aviatorblue62/sFPI/App/README.txt

Notes: 

Need to make windows image smaller to account for the small screen size.

Possibly measure the screen size with python and resize the image based on the screen size (i.e. crop it). 
This will be fine since the scaling will be determined by the ImageProcessing function.
