aviatorblue62/sFPI/Optical_Design/sfpi_layout.pdf

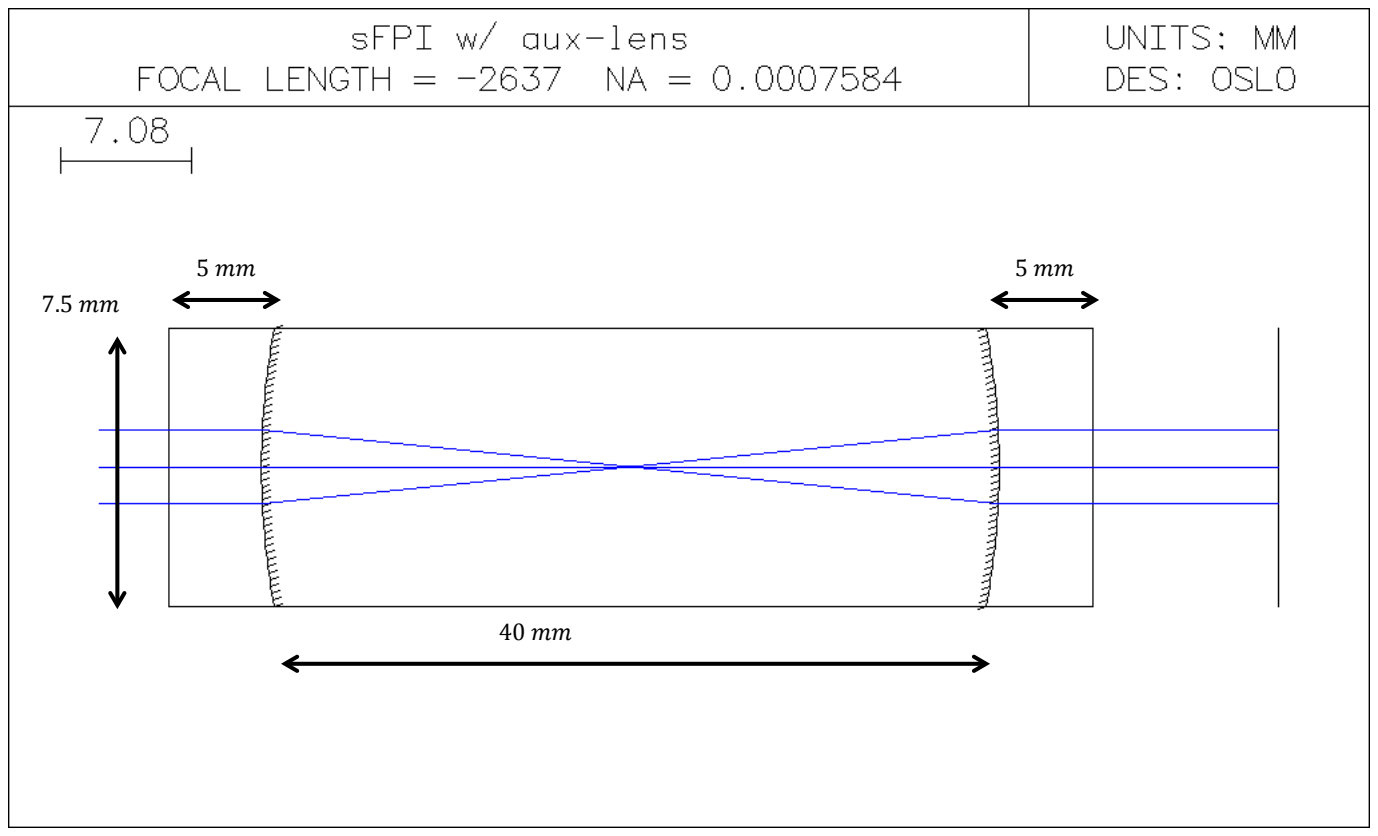
[picture p58: page 1]

7.5 mm

40 mm

5 mm | 5 mm
