aviatorblue62/sFPI/Docs/Thesis/OIT_Thesis.pdf

# The Design, Development and Implementation of a Scanning Fabry-Perot Interferometer

### David M Houston Oregon Institute of Technology

### April 7, 2015

# Contents

1 Background | 1
2 Motivation | 4
3 Proposed Plan | 5
4 Evaluation | 11
5 Timeline | 12
Appendices | 13
A Schematics | 14

# List of Figures

1.1 Resonant Cavity Setup | | 1
1.2 Auxiliary Lens Setup | | 2
1.3 Spectra Physics Model 476 High-Voltage Output | | 3
3.1 Block Diagram | | 5
3.2 Resonant Cavity Design | | 6
3.3 Resonant Cavity Mechanical Design | | 7
3.4 Ramp Function | | 8
3.5 RC Diode Circuit | | 8
3.6 Driver Amplifier | | 9
3.7 RLC Filter | | 9
3.8 Photodiode Output Circuit | | 10
5.1 Timeline | | 12
A.1 SP-476 Schematic | | 15
A.2 Amplifier Schematic | | 16

# List of Tables

3.1 Design Specification for Resonant Cavity | | 7
3.2 Design Specifications for Driver Amplifier of 5V sawtooth wave at 50 and 100 Hz . | 9
3.3 Specifications for sFPI Driver Output Signal | | 9
3.4 Design Specifications for Photodiode Transimpedance Amplifier | | 10

Project Goal

The goal of the project is to design, build, and implement a scanning mirror Fabry-Perot Interferometer. This device characterizes the spectral content of a laser beam. It will have a finesse of 155 and frequency spectral range of 3.748 GHz with a resolution of 24 MHz. A piezoelectric device will change the spacing of the mirrors, allowing scanning across the entire free spectral range. A driver will provide a controllable voltage signal to the piezoelectric device. The spectral frequency content will be captured by a photodetector and amplified by an adjustable transimpedance amplifier with a gain range of 50dB. A computer will process, display, and store this data locally on its hard disk.

# Section 1

# The Fabry-Perot Interferometer

The scanning Fabry-Perot Interferometer (sFPI) allows high-resolution optical spectroscopy. An example of this device is the Spectra Physics 470-04 Interferometer (SP-470-04), which is ”a mode degenerate, spherical mirror, Fabry-Perot interferometer”. It has a confocal resonant cavity with a minimum finesse of 150 and a free spectral range (FSR) of 8 GHz. This is calculated by Eq. 1.1 [6].

F

∗ = π

√
R
1 − R

(1.1)

The sFPI “can be used as a scanning spectrum analyzer..., as a static fringe interferometer, or as a tunable optical filter...” [6]. The SP-470-04 is comprised of a resonant cavity, capable of scanning, a driver, and a photo-detection setup for data analysis. The resonant cavity is constructed of a confocal mirror setup with an auxiliary lens as seen in Figures 1.1 and 1.2 [3].

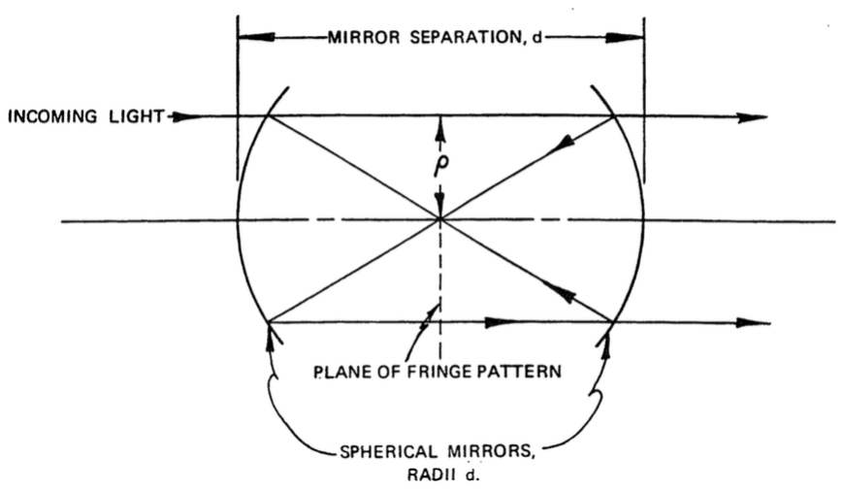
[picture p59: figure]

Figure 1.1: Resonant Cavity Mirror Setup [6]

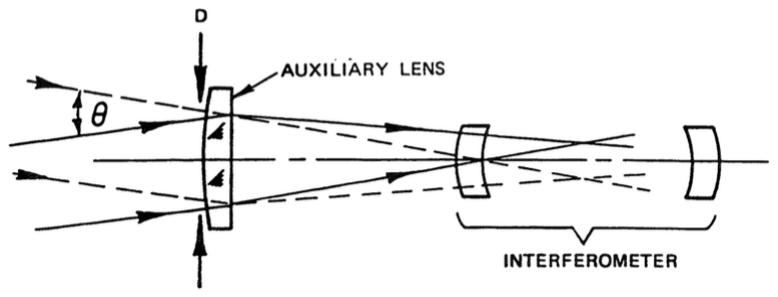
[picture p60: figure]

Figure 1.2: Incident Beam Diameter and Angular Divergence with Auxiliary Lens [6]

The first Fabry-Perot Interferometer was built using plane mirrors so as to be manipulated by changing their “relative orientation and particularly to render them rigorously parallel”. To properly calibrate the device, the mirrors were set to a calibrated distance which corresponded with the “first resolution of the two yellow lines of mercury” [2]. This design has changed over the years with the developments of the spherical mirror Fabry-Perot Interferometer (sFPI) and the internally coupled Fabry-Perot Interferometer (icFPI), which is simply a modification of the sFPI [3] [5]. The sFPI is free from considerations due to mode matching and has increased optical power making it more efficient for higher resolution spectroscopy. Because the sFPI is more sensitive to changes in the mirror separations, changing the geometry of the resonant cavity allows for the scanning through the FSR. [3].

There are two systems that can be used for changing the length of the resonant cavity. A pressure scanning system is used for scanning by a pressure differential to expand and contract the resonant cavity; however, its primary use is for static ultra-high resolution spectroscopy. The piezo-electrical scanning system, used by applying electrical charge, is utilized in spectrum analysis, tunable narrow bandpass filtering, and fringe interferometry [3]. The piezo-electric device operates as an transducer that ”when an electric field is applied... deformation (∆L) or strain (∆L/L) arises”. It has a corresponding impedance layout, that can be modeled using a resistor, capacitor, inductor circuit structure, with components corresponding to the piezoelectric motion and electrostatic capacitance [8]. To produce the scanning effect a saw-tooth electric signal is applied across the piezoelectric device causing a change in length of the cavity [8] [3].

The current driver, a Spectra Physics Model 476 Scanning Interferometer, produces a variable saw-tooth signal, as seen in Figure 1.3. It has the capabilities of producing a max voltage of 300V or 1kV with a variable amplitude, offset, and frequency for each condition [7].

The SP-476 uses Op-Amps, switches, varistors, and BJT’s (Figure A.2) to generate the unique sawtooth waveform. This allows for 5 different levels of amplification, a dc-biasing modulator for increased offset, as well as sweeping of the frequency from 0.002 - 0.2s to change the time of the scan. Because this driver is an all-in-one device, it also amplifies for the photodiode output, due to the incident light on it. It uses variable amplification, so as to tune the device with the output captured by an oscilloscope [7] (Figure A.1).


Figure 1.3: Spectra Physics Model 476 High-Voltage Output [7]

# Section 2

# The Motivation for Constructing the sFPI

The construction and current means of controlling the sFPI motivates investigation into the potential to exploit the current construction of the resonant cavity and improving the means of controlling the device and measuring its functional output. For example, the SP-470-04 is a viable platform and product to compare to when designing the resonant cavity. In order to improve this setup, mirrors with a specific dielectric coating will produce a nominal finesse of 155, quite similar to the finesse of 150 as seen with the SP-470-04, see Equ. 1.1, and reduce the FSR from 8 GHz to 3.75 GHz, see Equ. 3.1 [5] [3]. These mirrors will use a piezoelectric device which will be driven by a driver quite similar in operation to the SP-467 Driver. The current configuration for the sFPI driver, as described above by the SP-476, will be modified to a lower voltage of 30V with displayable values for inputs as well as the outputs. This will improve the current design by providing a calculated result of the transmission peaks as a function of the wavelength. The setup for the sampling will perfect the current model by reducing the reset time of the photodiodes as well as consolidating the driving signal and the photodiode signal into a single graphical and quantifiable output by means of data analysis.

# Section 3

The Plan for the Design, Development,

# and Implementation of the Fabry-Perot Interferometer

## 3.1 Outline

The plan has three parts: the scanning Fabry-Perot Interferometer, the driver, and the photodiode captured digital output. The sFPI will consist of an optical input, which will be controlled by a driver. The resulting output will be captured by a photodiode and then digitally analyzed (Figure 3.1)¹


Figure 3.1: Block Diagram of System Setup

1The Block Diagram was made using Lucidchart. For definitions on the flowchart identifiers see their website https://www.lucidchart.com/.

## 3.2 Resonant Cavity

The optical input as illustrated Figure 3.1 above will consist of the sFPI. This delicate structure is an active system comprised of a two-confocal mirror resonant cavity, a piezoelectric device, and a photodiode. The resonant cavity for the device is represented in Figure 3.2. In order to determine the optimal distance between the lens and the first mirror, samples will be taken and the transmission peaks will be compared with those of the peaks of the SP-470-04 interferometer sample.


Figure 3.2: The resonant cavity design, with measurements

∆v = c/2L | (3.1)

∆δ = ∆v/F∗
(3.2)

The finesse of the sFPI is calculated based on the reflectivity of the mirrors (Eq. 1.1) [1]. The FSR of the resonant cavity of the sFPI is determined by Eq. 3.1 and the bandwidth is calculated by Eq. 3.2 [4] [9]. The lens system will be held in place by a setup which holds the two spherical mirrors 40 mm apart and the auxiliary lens to promote maximum transmission of the modes (Figure 3.3). Table 3.1 details the design specifications for the resonant cavity.

The length of the resonant cavity will be adjustable for calibration purposes. After calibration, the length and origination of the cavity will remain constant. However, the angle of incidence as determined by the auxiliary focusing lens, will be variable so as to position for maximum transmission.

Quantity Minimum Maximum

L | 40 mm
∆v | 3.748 GHz
R | 95% | 98%
F
∗ | 61 | 155
∆δ | 61.2 MHz | 24.2 MHz

Table 3.1: Design Specification for Resonant Cavity


Figure 3.3: Resonant Cavity Mechanical Design

## 3.3 The Driver

The driver will be constructed using an Arduino UNO micro-controller. The Arduino UNO will take in a set of analog signal values in order to control the output. These analog signals will be attenuated DC voltage levels ranging from 0-5V. The bit resolution for the ADC is 10 bits, which twill allow for 2¹⁰ (or 1024) individual definable levels for the controls. The characteristics that will be controllable are the amplitude, time on, and the DC offset. These analog signals will be converted into digital signals, averaged every data cycle, and analyzed by the Arduino. The values will correspond to writeable outputs, which the Arduino will send to the DAC via I2C. The DAC will produce a 5V sawtooth voltage signal with a bit resolution of 1.2 mV/bit (Figure 3.4).

The frequency of the signal will be controlled by the value from the analog input and will only change the amount of time the signal is on (Eq. 3.3) The off, or rest, time is determined by the photodiode. The photodiode will be tested to determine the discharge time by measuring the time constants in a circuit configuration (Figure 3.5).


Figure 3.4: Graphical Representation of the Stair Step Ramp Function

fr = (ton + tof f )

(−1) | (3.3)


Figure 3.5: Setup for measuring decay constant of the photodiode

The 5V sawtooth wave function will be fed to a filtered amplifier to amplify the signal based on a series-shunt feedback loop (Figures 3.6, 3.7). Table 3.2 list the specifications for the amplifier² .

The Arduino–DAC-Amplifier component will have an impedance as described in Eq. 3.4 and rated to 60 mW when the Thevinin impedance of the circuit is equivalent to the load impedance of piezoelectric device.

Pmax ∼ Zth = Z

∗
load | (3.4)

2These values were taken by measuring the impedance of the piezoelectric device

Quantity | Value (50 Hz) | Value (100 Hz)
Aclmax | 7V/V
Aclmin | 0.1V/V
fc | 200 Hz
Zload | 370 − j2.0499 ∗ 10⁵ Ω 370 − j1.0250 ∗ 10⁵ Ω
Zout | 370 + j2.0499 ∗ 10⁵ Ω 370 + j1.0250 ∗ 10⁵ Ω

Table 3.2: Design Specifications for Driver Amplifier of 5V sawtooth wave at 50 and 100 Hz

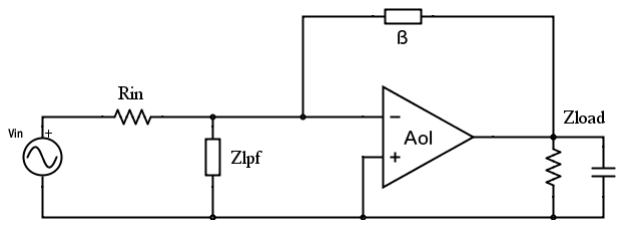
[picture p61: figure]

Figure 3.6: 1st Order Driver Amplifier for 5V Sawtooth Wave

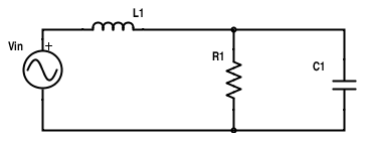
[picture p62: figure]

Figure 3.7: RLC Filter

Table 3.3 details the specifications of the the final signal delivered to the piezoelectric device.

Quantity Minimum Maximum

Vpp | 0.5 V | 30 V
Vdc | 0 V | 30 V
Vstep | 122 µV | 1.2 mV
f | 50 Hz | 100 Hz

Table 3.3: Specifications for sFPI Driver Output Signal

## 3.4 The Processor

The photodiode will be mounted to an adjustable plate at the rear of the sFPI for calibration, for maximum transmission of the spectral content. The photodiodes resulting current will be reverse biased and amplified by a transimpedance negative-feedback amplifier (Figure 3.8). Table 3.4 details the specifications for the shunt-shunt transimpedance photodiode amplifier.

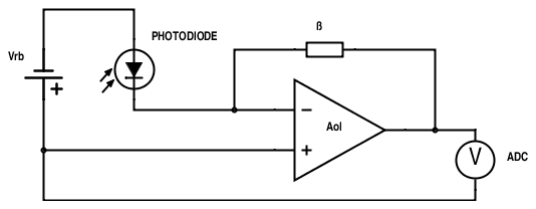
[picture p63: figure]

Figure 3.8: Reverse Biased Transimpedance Amplifier of the Photodiode output

Quantity Minimum Maximum

VADC | 0 V | 5 V
ACL | AOL/(1 + AOLβ) V/A

Table 3.4: Design Specifications for Photodiode Transimpedance Amplifier.

## 3.5 The Digital Output

The content captured by the ADC (Figure 3.8) will be transmitted to a computer to process, display (by a graphical representation), and store the data. This data will be combined in conjunction with the 5V sawtooth signal to plot the photodiode signal as a function of the geometrical change of the resonant cavity, which is proportional to the wavelength of the light. This will be done via a GUI model with a language that possesses the capability for universal interfacing. Python will be the base model for programming; however, other languages will be tested for user interface and compared based on speed, cross-platform configuration, and simplicity.

# Section 4

# The Evaluation of the sFPI

The resonant cavity will have a Finesse of 155 ± 1 a FSR of 3.75 ± 0.1 GHz and a bandwidth of 24 ± 0.1 MHz. This will be tested by (See Finesse Measure PDF). To test the sFPI driver, the system will be setup with an output to a piezoelectric load and the voltage will be measured at different settings of the device. It will have a maximum peak-to-peak voltage of 30 ± 0.01V , a maximum DC voltage of 30 ± 0.01V , a maximum bit voltage of 8.4 ± 0.01 mV, and a frequency range of 50 − 100 ± 0.1 Hz. The final test will be to measure the spectral frequency content of a HeNe laser and comparing the corresponding graphical output to the output of a SP-470-04 Interferometer. The final results must be within 1% of each other.

# Section 5

# Explicit Timeline of the Proposed Project


Figure 5.1: Timeline

# Appendices

# Appendix A

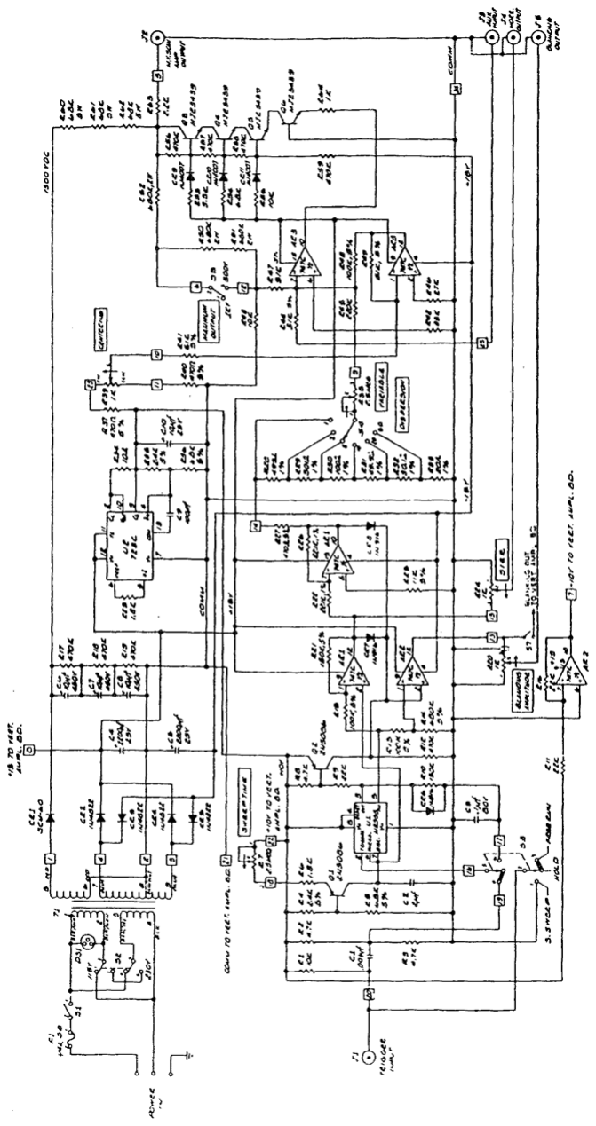
[picture p64: figure]

Figure A.1: SP-476 Schematic [7]

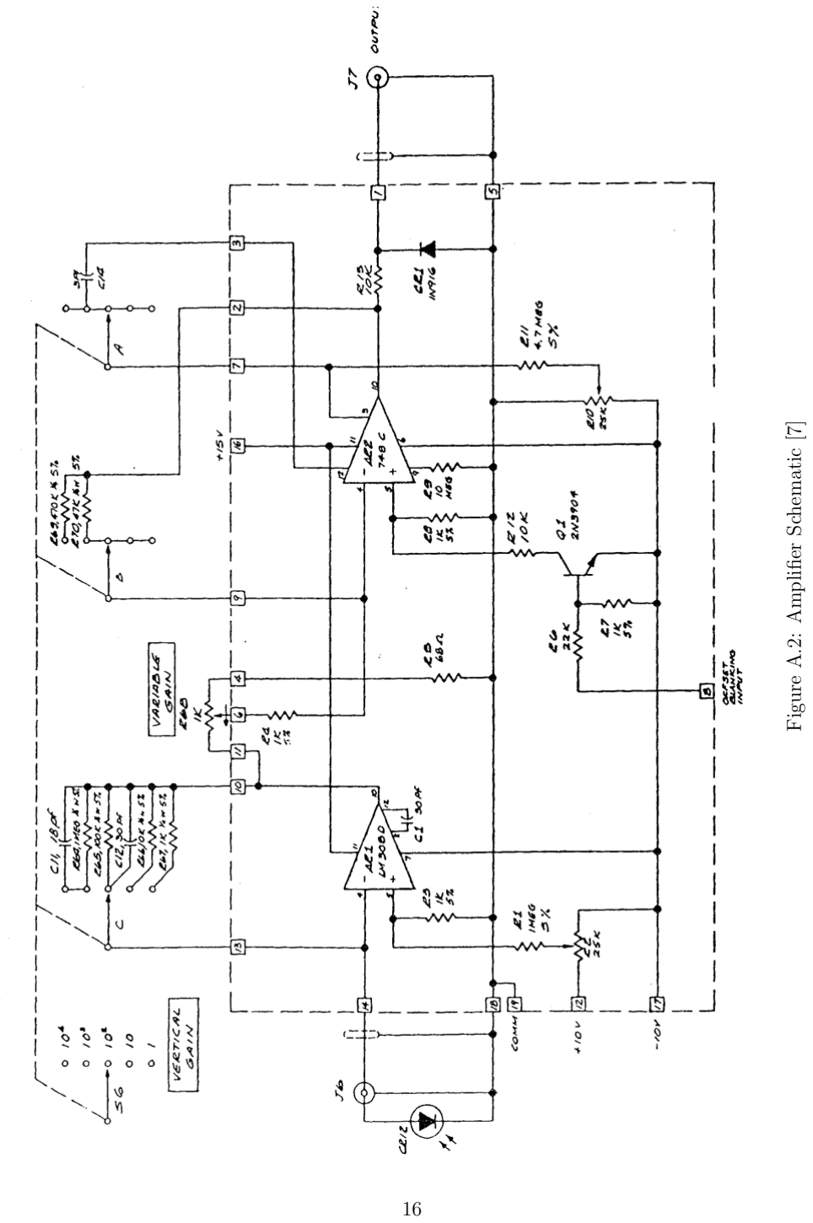
[picture p65: page 21]

Figure A.2: Amplifier Schematic [7]

# Bibliography

[1] Instructions for scanning fabry-perot interferometer kit 1, 2013.
[2] CH. Fabry and A. Perot. On a new form of interferometer. Astrophysical Journal, 9:87, 1901.
[3] Michael Hercher. The spherical mirror fabry-perot interferometer. Applied Optics, 7(5):951– 966, 1968.
[4] F. Jenkins and H. E. White. Fundamentals of Optics. McGraw Hill, 1950.
[5] M. Reich, R. Schieder, H. Clar, and G Winnewisser. Internally coupled fabry-perot interferometer for high precision wavelength control of tunable diode lasers. Applied Optics, 25(1):5, 1986.
[6] Spectra Physics: Laser Instrument Division. Model 470 Interferometer.
[7] Spectra Physics: Laser Instrument Division. Model 476 Scanning Interferometer Driver, 1979.
[8] Kenji Uchino. Introduction to piezoelectric actuators and transducers. 25 1, Penn State University, 1986.
[9] A. Zajac and E. Hecht. Optics. Pearson Higher Education, 4 edition, 2003.

# Nomenclature

∆ v | The free spectral range
λ | The wavelength of light in nanometers
c | The speed of light

F

∗ | The finesse of the resonant cavity
L | The length of the resonant cavity
R | The reflectivity of the mirrors
