aviatorblue62/sFPI/App/version.txt

# UTF-8
#
# For more details about fixed file info 'ffi' see:
# http://msdn.microsoft.com/en-us/library/ms646997.aspx
VSVersionInfo(
  ffi=FixedFileInfo(
    # filevers and prodvers should be always a tuple with four items: (1, 2, 3, 4)
    # Set not needed items to zero 0.
    filevers=(96, 12, 19, 1),
    prodvers=(4, 1, 2, 1),
    # Contains a bitmask that specifies the valid bits 'flags'
    mask=0x3f,
    # Contains a bitmask that specifies the Boolean attributes of the file.
    flags=0x0,
    # The operating system for which this file was designed.
    # 0x4 - NT and there is no need to change it.
    OS=0x4,
    # The general type of file.
    # 0x1 - the file is an application.
    fileType=0x1,
    # The function of the file.
    # 0x0 - the function is not defined for this fileType
    subtype=0x0,
    # Creation date and time stamp.
    date=(0, 0)
    ),
  kids=[
    StringFileInfo(
      [
      StringTable(
        u'040904b0',
        [StringStruct(u'CompanyName', u’Oregon Institute of Technology’),
        StringStruct(u'ProductName', u’sFPI - GUI’),
        StringStruct(u'ProductVersion', u’1, 0, 0, 0'),
        StringStruct(u'InternalName', u’GUI’),
        StringStruct(u'OriginalFilename', u’sFPI-GUI.exe'),
        StringStruct(u'FileVersion', u'96, 12, 19, 1'),
        StringStruct(u'FileDescription', u’Vault’),
        StringStruct(u'LegalCopyright', u'Copyright 2015 David Houston'),
        StringStruct(u'LegalTrademarks', u’sFPI-GUI is a registered trademark of David Houston’),])
      ]),
    VarFileInfo([VarStruct(u'Translation', [1033, 1200])])
  ]
)
