aviatorblue62/sFPI/Electrical_Design/Amplifier_Design/Driver_Input-vs-Output.pdf

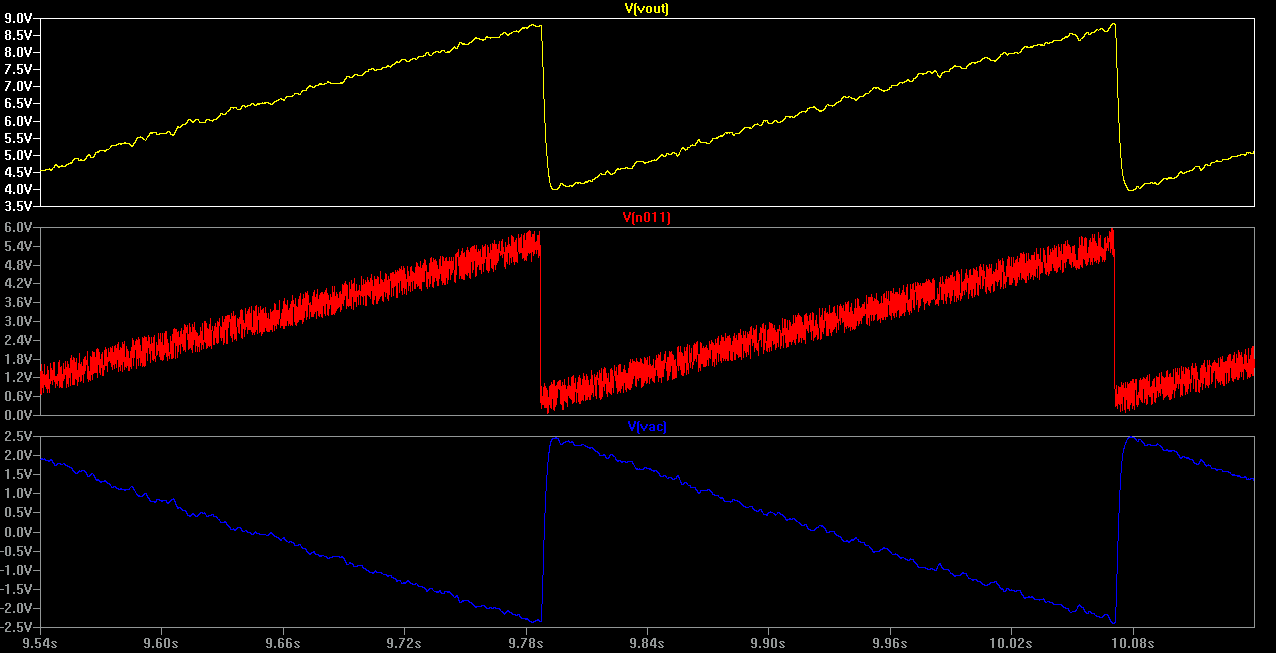
[picture p80: page 1]
