aviatorblue62/sFPI/Electrical_Design/Photodiode_Amplifier/Spectra_Physics-sFPI-Data_Analysis-Transimpedance_Amplifier-ADC_Digital-Filter.pdf

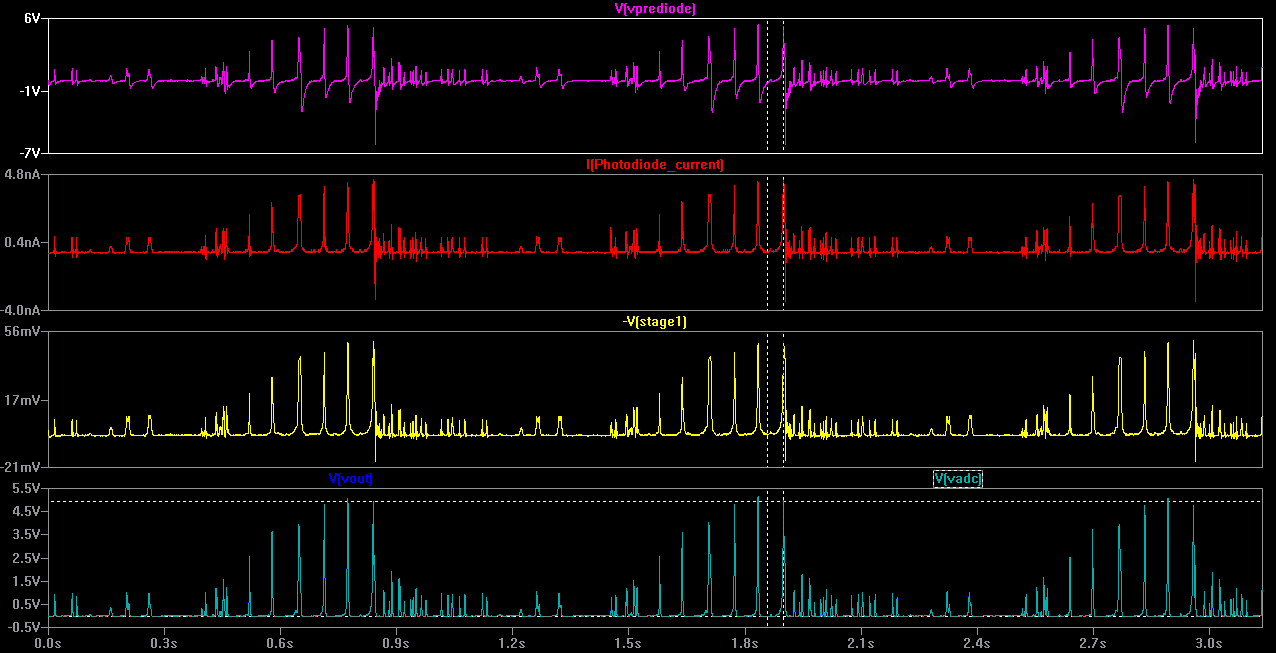
[picture p81: page 1]
