aviatorblue62/sFPI/Electrical_Design/Photodiode_Amplifier/Spectra_Physics-sFPI-Data_Analysis-Transimpedance_Amplifier.pdf

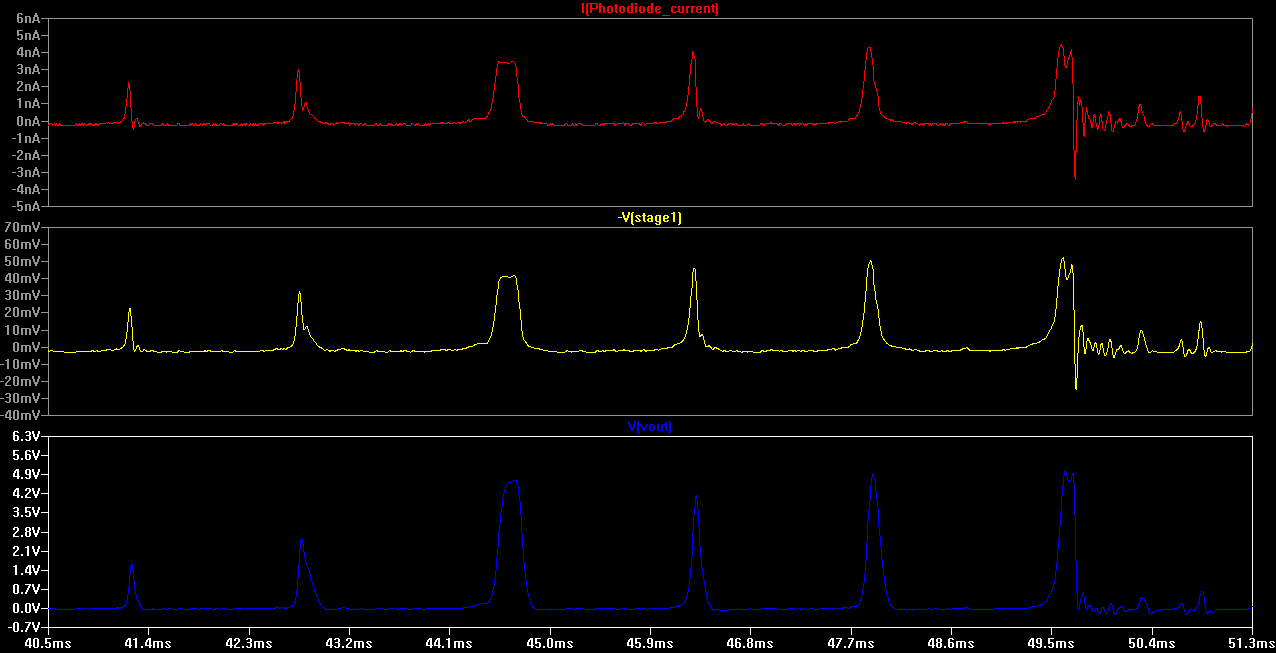
[picture p82: page 1]
