aviatorblue62/sFPI/PCB/Schematics/Driver_Schematic.pdf

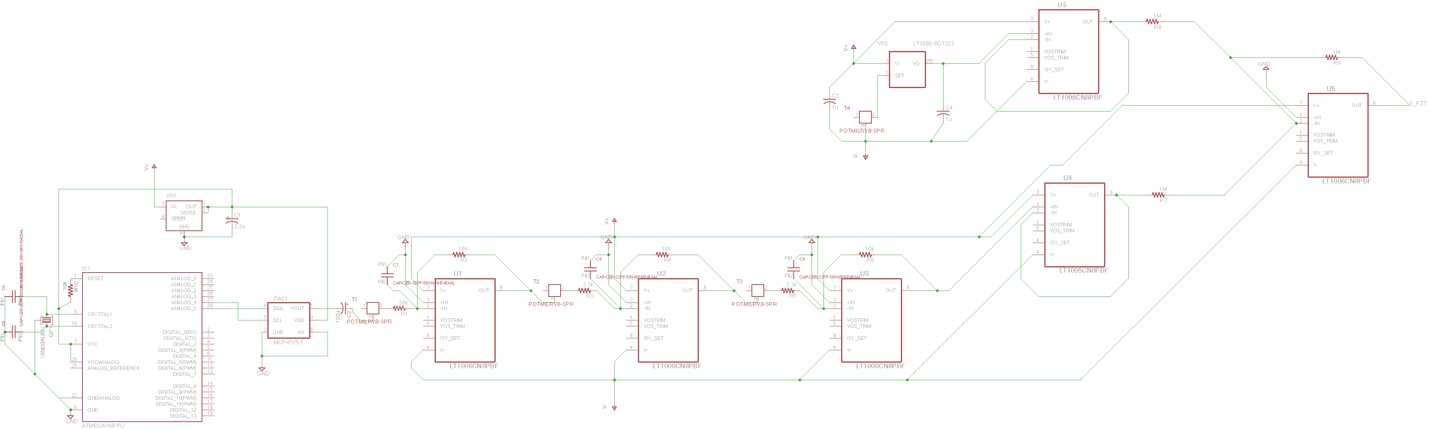
[picture p83: figure]
