aviatorblue62/sFPI/Electrical_Design/Electrical-Schematic/LTSpice-sFPI-Driver.pdf

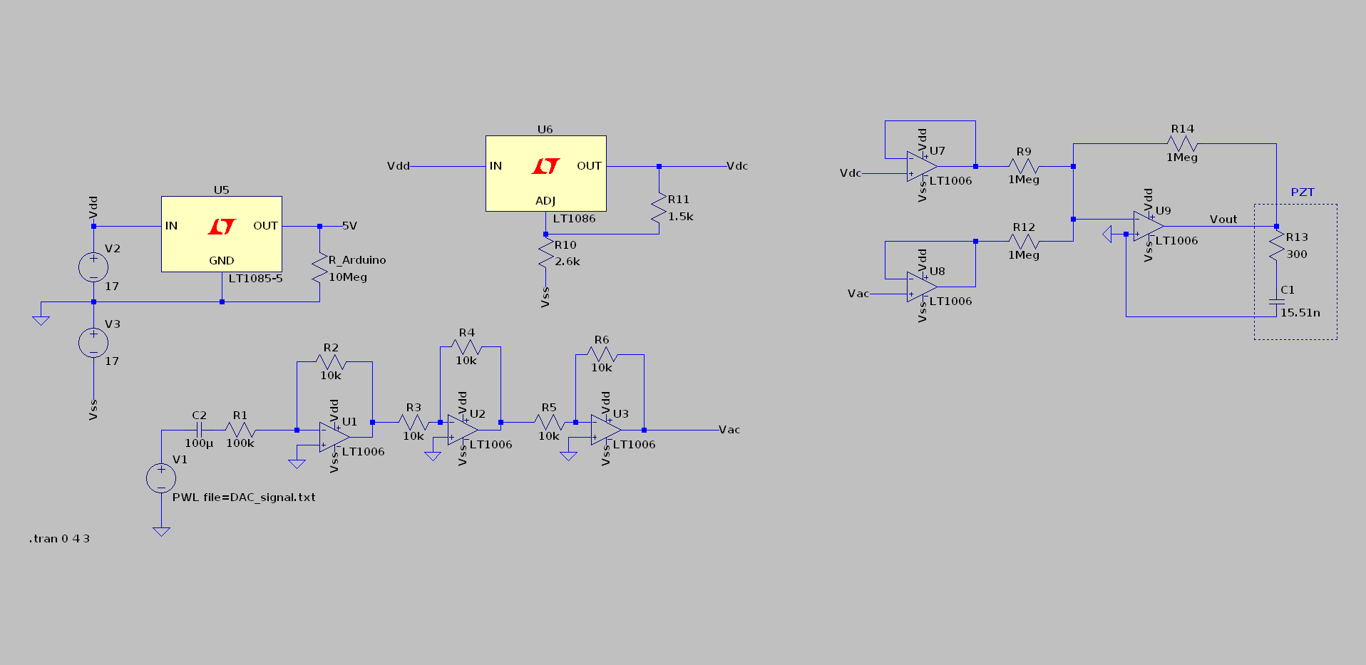
[picture p84: page 1]
