aviatorblue62/sFPI/Thesis/images/Gantt_Chart_updated.pdf

Task | Start Date | End Date | Duration (days) | Notes
Project Proposal | 5-Jan | 20-Mar | 74 This contains in full the reason behind the project and all of the processes that encompass it.
Documentation | 16-Jan | 21-Aug | 217 This will a be a process of documenting all intecations and ideas associated with the project
Theorical Desiging | 16-Jan | 25-Feb | 40 This entitles the theoretical desiging the entire system from start to finish based on models and diagrams
Testing/Confirming | 26-Jan | 20-Mar | 53 This ecompasses testing all devices for optimum usage and parts for cofirmation on desired specifcations and proof of concept
Applicable Re-Design | 20-Mar | 3-Apr | 14 | This will comprise of taking the original deisgn and compiling all components into a fluid electrical system cabable accurate and function synthesis.
Simulating | 27-Mar | 17-Apr | 21 This will ecompass building simulatable computer designs of all modules of the project and simulating their processes to deterime the bevaoir of these systems.
Constructing | 10-Apr | 1-May | 21 This will be a process focuses on simply physically constrcuting the protoype of the system for testing and optimization
Testing/Stressing | 24-Apr | 8-May | 14 This will consist of testing the device and stressing it to its local range of pheseable operation
Optimizing | 1-May | 22-May | 21 This will aim at increasing that range of operation so as to make the device more effective and effceint
Reconfiguring | 15-May | 29-May | 14 This will consist of taking the data from the testing and optimization and compiling it into a configuration which will be designed for implementation and final outcome
Implemeting | 22-May | 21-Aug | 91 This will be the process of impelemting the newly configured design with the desired purpose of that device so as to prove effectiveness.
Improving | 29-May | 14-Aug | 77 This will consist of taking new and improved steps at changing the newly implemented device to imporve functionality as well as user interfacing and precision
Finalizing Presention/Documentation | 29-May | 21-Aug | 84 This is the compliation of all data collected over the period of the project as well as the processies used inroder for presentation as to the projects effectivness.
Final Testing/Confiuration Setup | 7-Aug | 21-Aug | 14 This is the final testing proving effectivness for industry production and use .

# Project Timeline

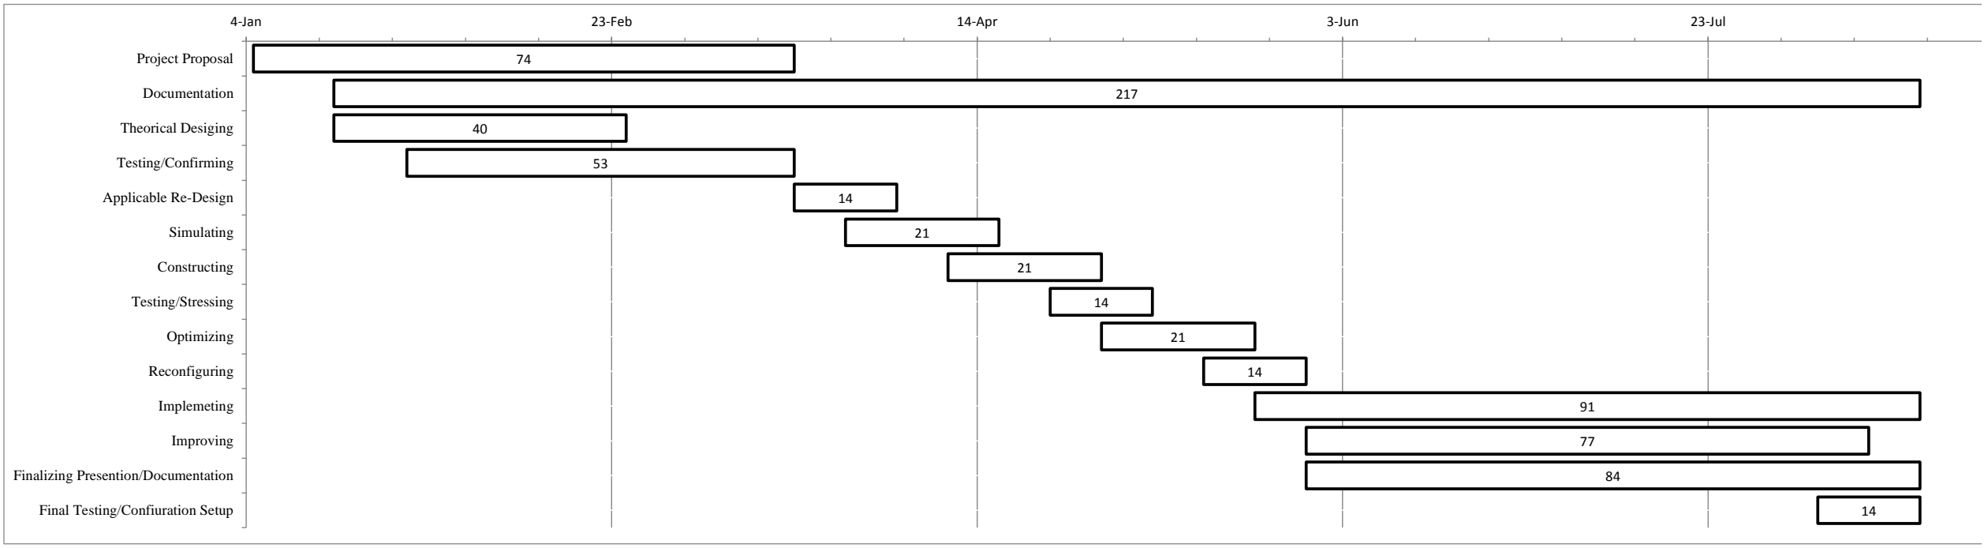
[picture p85: figure]
4-Jan; 23-Feb; 14-Apr; 3-Jun; 23-Jul; Project Proposal; Documentation; Theorical Desiging; Testing/Confirming; Applicable Re-Design; Simulating; Constructing; Testing/Stressing; Optimizing; Reconfiguring; Implemeting; Improving; Finalizing Presention/Documentation; Final Testing/Confiuration Setup
