aviatorblue62/sFPI/Thesis/images/sfpi_layout.pdf

sfpi_layout.bmp | https://drive.google.com/drive/#folders/0B0QXvzIDerbR...

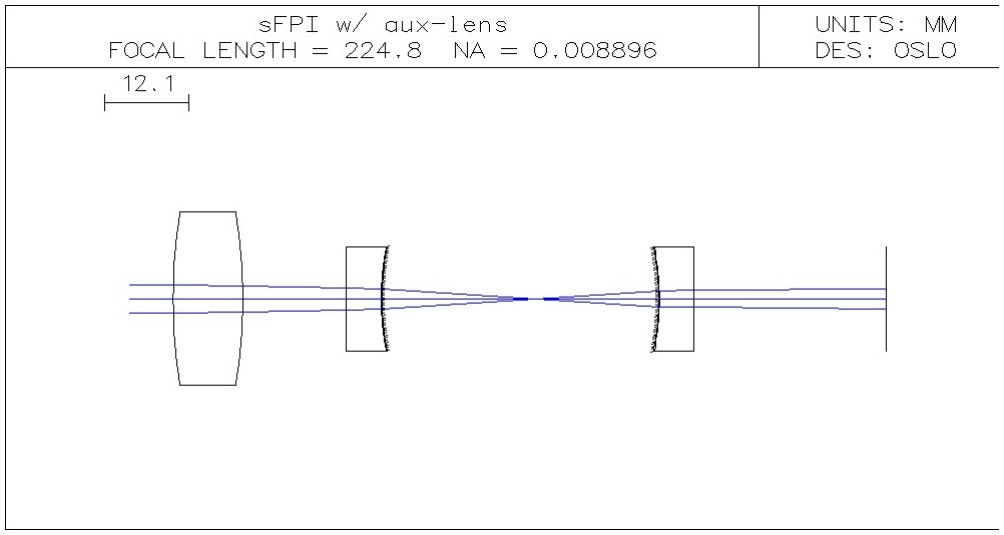
[picture p86: figure]

1 of 1 | 3/14/15, 11:56 PM
