aviatorblue62/sFPI/Docs/ramp_func.pdf

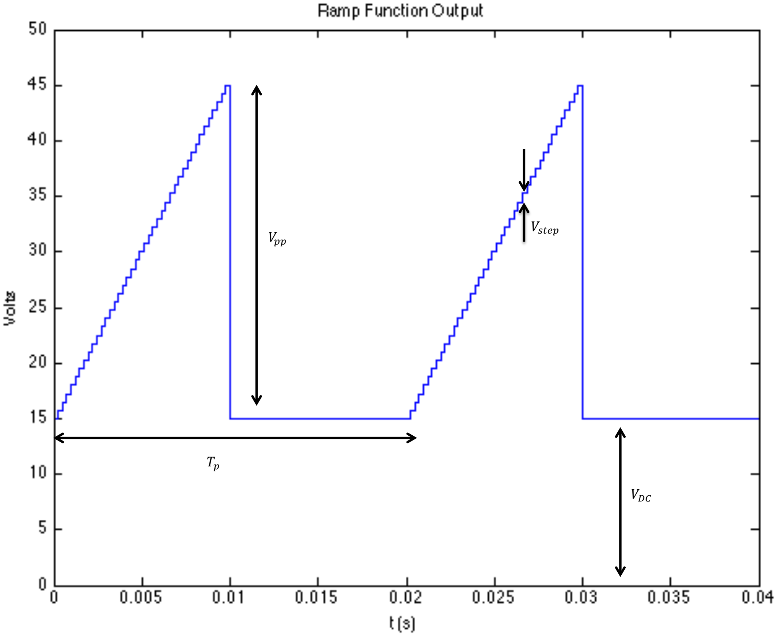
[picture p87: page 1]

V!"

T!

V!!

V!"#$
