aviatorblue62/sFPI/Docs/timeline.pdf

Task | Start Date | End Date Duration (days)
Project Proposal | 5-Jan | 20-Mar | 74
Documentation | 16-Jan | 21-Aug | 217
Theorical Desiging | 16-Jan | 25-Feb | 40
Testing/Confirming | 26-Jan | 20-Mar | 53
Applicable Re-Design | 20-Mar | 3-Apr | 14
Simulating | 27-Mar | 17-Apr | 21
Constructing | 10-Apr | 1-May | 21
Testing/Stressing | 24-Apr | 8-May | 14
Optimizing | 1-May | 22-May | 21
Reconfiguring | 15-May | 29-May | 14
Implemeting | 22-May | 21-Aug | 91
Improving | 29-May | 14-Aug | 77
Finalizing Presention/Documentation | 29-May | 21-Aug | 84
Final Testing/Confiuration Setup | 7-Aug | 21-Aug | 14

# Project Timeline

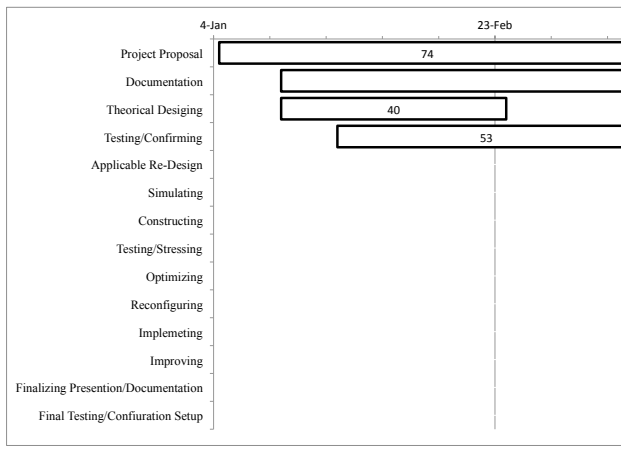
[picture p88: figure]
4-‐Jan; 23-‐Feb; Project Proposal; Documentation; Theorical Desiging; Testing/Confirming; Applicable Re-Design; Simulating; Constructing; Testing/Stressing; Optimizing; Reconfiguring; Implemeting; Improving; Finalizing Presention/Documentation; Final Testing/Confiuration Setup
