aviatorblue62/sFPI/Docs/Gantt_Chart/Gantt_Chart.pdf

Task | Start Date | End Date
Project Proposal | 5-Jan | 20-Mar
Documentation | 16-Jan | 21-Aug
Theorical Desiging | 16-Jan | 25-Feb
Testing/Confirming | 26-Jan | 20-Mar
Applicable Re-Design | 20-Mar | 3-Apr
Simulating | 27-Mar | 17-Apr
Constructing | 10-Apr | 1-May
Testing/Stressing | 24-Apr | 8-May
Optimizing | 1-May | 22-May
Reconfiguring | 15-May | 29-May
Implemeting | 22-May | 21-Aug
Improving | 29-May | 14-Aug
Finalizing Presention/Documentation | 29-May | 21-Aug
Final Testing/Confiuration Setup | 7-Aug | 21-Aug

# Project Timeline

8-‐Oct

27-‐Nov

16-‐Jan

Project Proposal

Documentation

Theorical Desiging

Testing/Confirming

Applicable Re-Design

Simulating

Constructing

Testing/Stressing

Optimizing

Reconfiguring

Implemeting

Improving

Finalizing Presention/Documentation

Final Testing/Confiuration Setup

Duration (days)
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
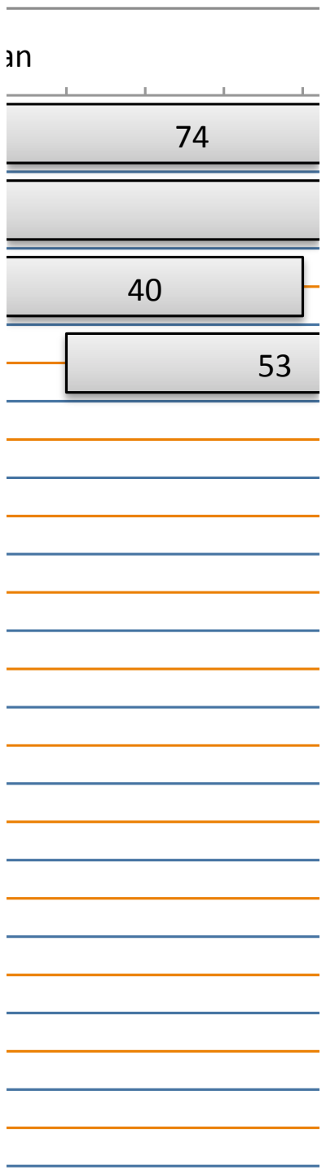
[picture p89: figure]
16-‐Jan

Notes
This contains in full the reason behind the project and all of the processes that encompass it.
This will a be a process of documenting all intecations and ideas associated with the project
This entitles the theoretical desiging the entire system from start to finish based on models and diagrams
This ecompasses testing all devices for optimum usage and parts for cofirmation on desired specifcations and proof of concept
This will comprise of taking the original deisgn and compiling all components into a fluid electrical system cabable accurate and function synthesis.
This will ecompass building simulatable computer designs of all modules of the project and simulating their processes to deterime the bevaoir of these systems. This will be a process focuses on simply physically constrcuting the protoype of the system for testing and optimization
This will consist of testing the device and stressing it to its local range of pheseable operation
This will aim at increasing that range of operation so as to make the device more effective and effceint
This will consist of taking the data from the testing and optimization and compiling it into a configuration which will be designed for implementation and final outcome This will be the process of impelemting the newly configured design with the desired purpose of that device so as to prove effectiveness.
This will consist of taking new and improved steps at changing the newly implemented device to imporve functionality as well as user interfacing and precision
This is the compliation of the project from start to finish and the problems, processies utilized, and overall achivements of the project.
This is the final stage of testing that will demonstrate the final effectivness of the device as well as its completeness and readiness for industry standard production.

7-‐Mar

26-‐Apr

15-‐Jun

4-‐Aug

23-‐Sep

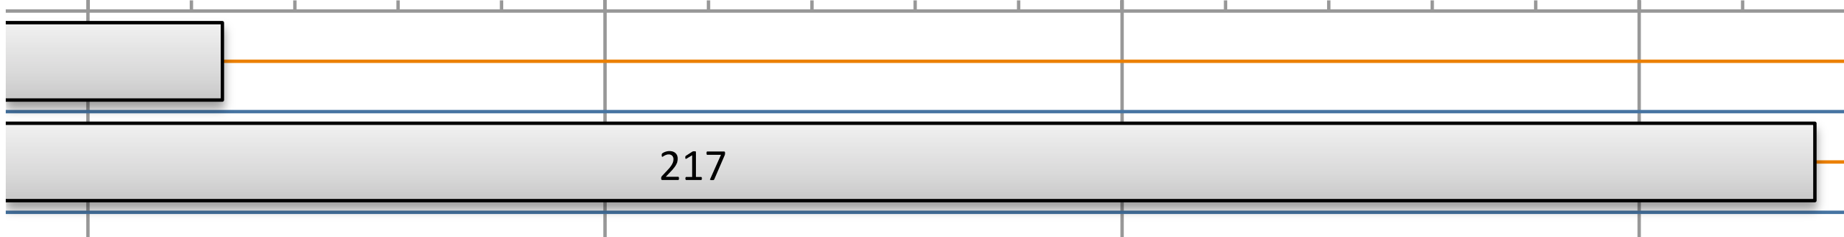
[picture p90: figure]
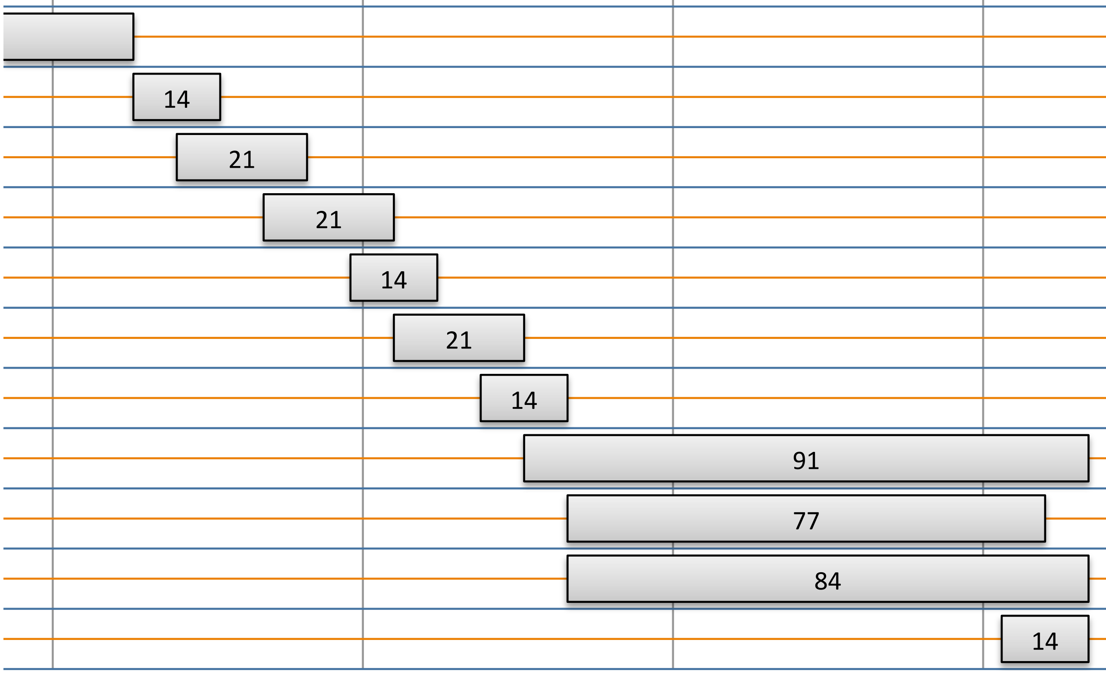
[picture p91: figure]
