aviatorblue62/sFPI/Electrical_Design/Photodiode_Amplifier/Photodiode_Amplifier_Output-vs-Input.xls

 | Area | Mean | Min | Max | Angle | Length
1 | 0.001 | 6.198 | 0 | 42.451 | -3.366 | 0.154
2 | 0.001 | 12.765 | 0 | 85.320 | 0 | 0.148
3 | 0.001 | 7.756 | 0 | 42.562 | 0 | 0.154
4 | 0.001 | 10.428 | 0 | 42.563 | 0 | 0.136
5 | 0.001 | 16.518 | 0 | 85.333 | 0 | 0.113
6 | 0.001 | 13.077 | 0 | 42.667 | 0 | 0.107
7 | 7.888E-4 | 14.627 | 0 | 42.543 | 6.340 | 0.077
8 | 6.311E-4 | 34.377 | 0 | 84.889 | 0 | 0.065
9 | 6.311E-4 | 18.839 | 0 | 42.333 | 0 | 0.065
