aviatorblue62/sFPI/Docs/Gantt_Chart/Gantt_Chart_files/image001.png

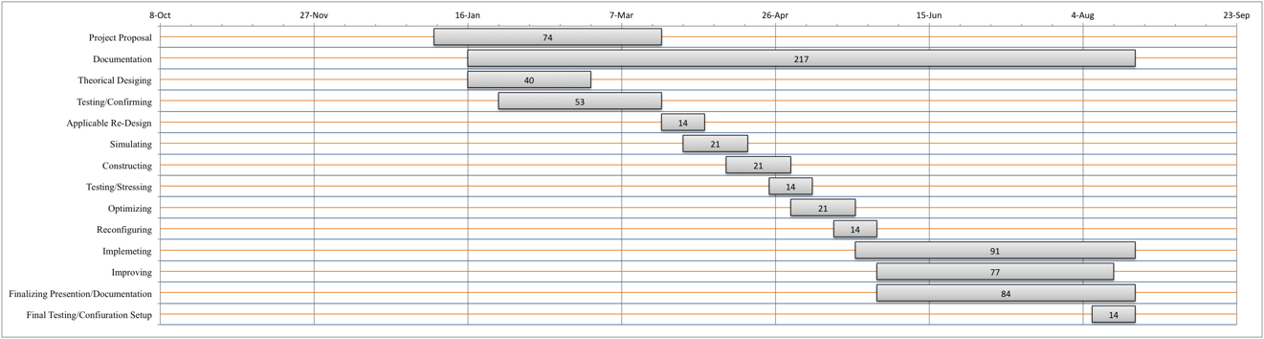
Docs/Gantt_Chart/Gantt_Chart_files/image001.png
