aviatorblue62/sFPI/Docs/Scanning Fabry-Perot Interferometer_files/150-5081_IMG.jpg

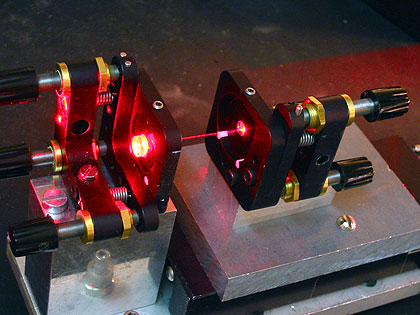
Docs/Scanning Fabry-Perot Interferometer_files/150-5081_IMG.jpg
