aviatorblue62/sFPI/Docs/Scanning Fabry-Perot Interferometer_files/153-5323_IMG-2.jpg

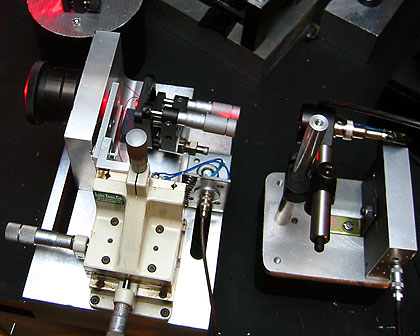
Docs/Scanning Fabry-Perot Interferometer_files/153-5323_IMG-2.jpg
