aviatorblue62/sFPI/Docs/Scanning Fabry-Perot Interferometer_files/geso-SFPI.jpg

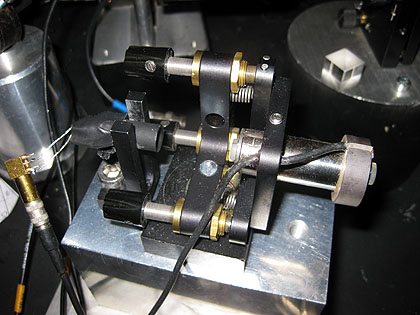
Docs/Scanning Fabry-Perot Interferometer_files/geso-SFPI.jpg
