aviatorblue62/sFPI/Docs/Scanning Fabry-Perot Interferometer_files/SFPI2-1.jpg

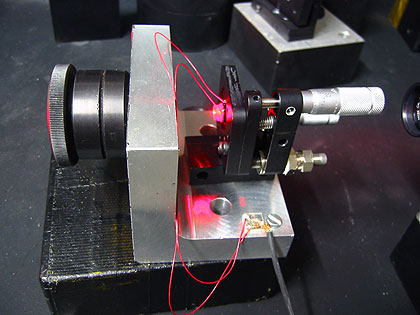
Docs/Scanning Fabry-Perot Interferometer_files/SFPI2-1.jpg
