aviatorblue62/sFPI/Docs/Scanning Fabry-Perot Interferometer_files/SFPI-ampli-1.0.png

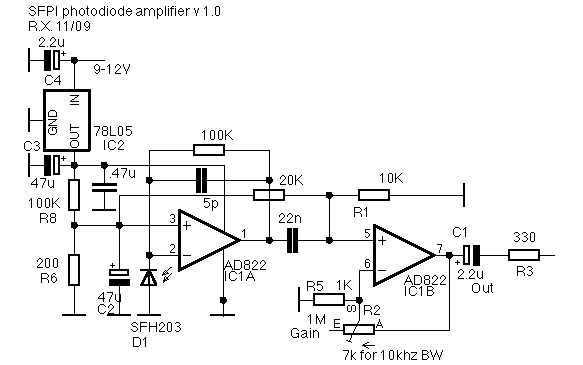
Docs/Scanning Fabry-Perot Interferometer_files/SFPI-ampli-1.0.png
