aviatorblue62/sFPI/Docs/Scanning Fabry-Perot Interferometer_files/SFPIamp.jpg

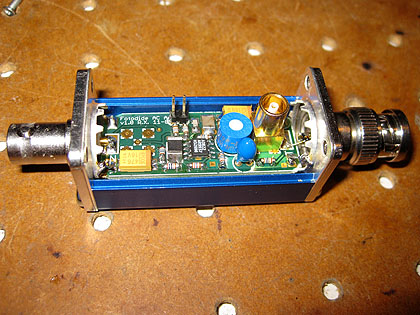
Docs/Scanning Fabry-Perot Interferometer_files/SFPIamp.jpg
