aviatorblue62/sFPI/Docs/Scanning Fabry-Perot Interferometer_files/SPmirrors.jpg

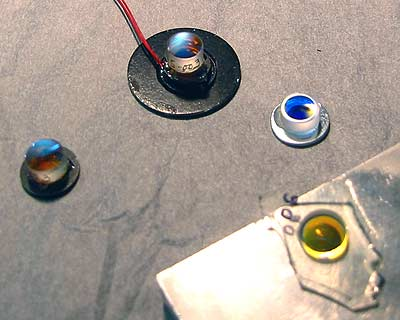
Docs/Scanning Fabry-Perot Interferometer_files/SPmirrors.jpg
