aviatorblue62/sFPI/Docs/Scanning Fabry-Perot Interferometer_files/SPmirrorsMounted.jpg

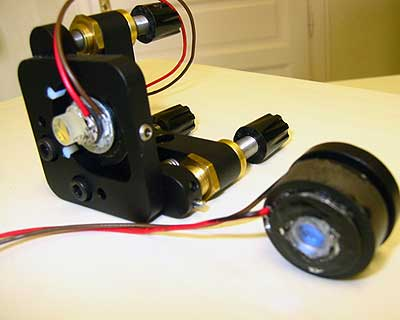
Docs/Scanning Fabry-Perot Interferometer_files/SPmirrorsMounted.jpg
