aviatorblue62/sFPI/Docs/state_machine.png

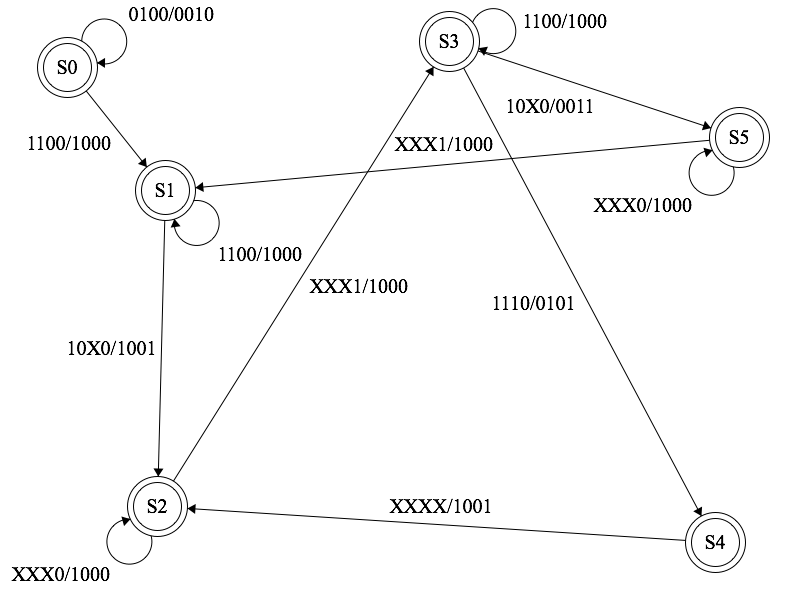
Docs/state_machine.png
