aviatorblue62/sFPI/Docs/Thesis/images/holder.png

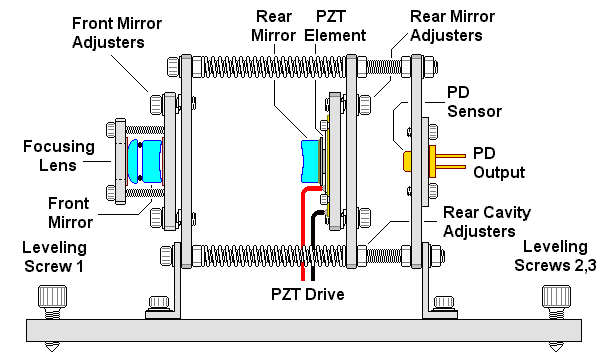
Docs/Thesis/images/holder.png
