aviatorblue62/sFPI/Electrical_Design/ac-dc-signal-output.jpg

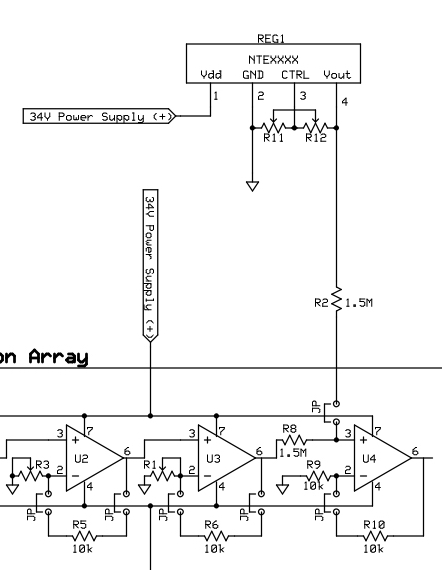
Electrical_Design/ac-dc-signal-output.jpg
