aviatorblue62/sFPI/Electrical_Design/Amplification-Array.jpg

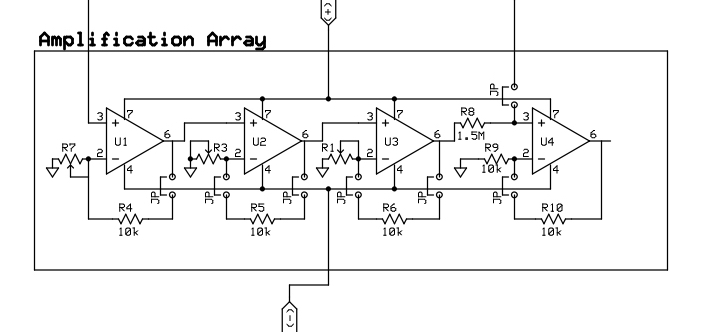
Electrical_Design/Amplification-Array.jpg
