aviatorblue62/sFPI/Electrical_Design/Function_generator.jpg

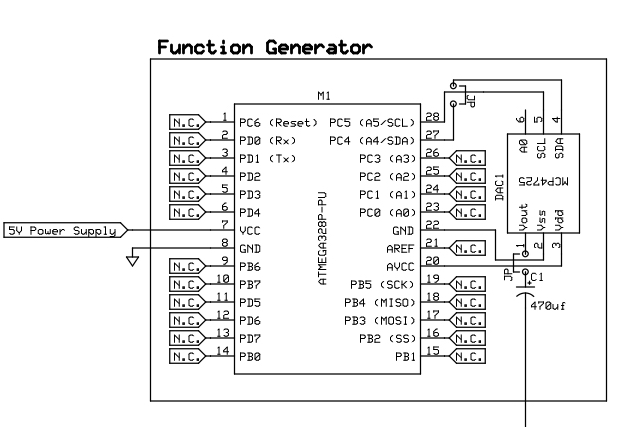
Electrical_Design/Function_generator.jpg
