aviatorblue62/sFPI/Electrical_Design/schematic-driver.jpg

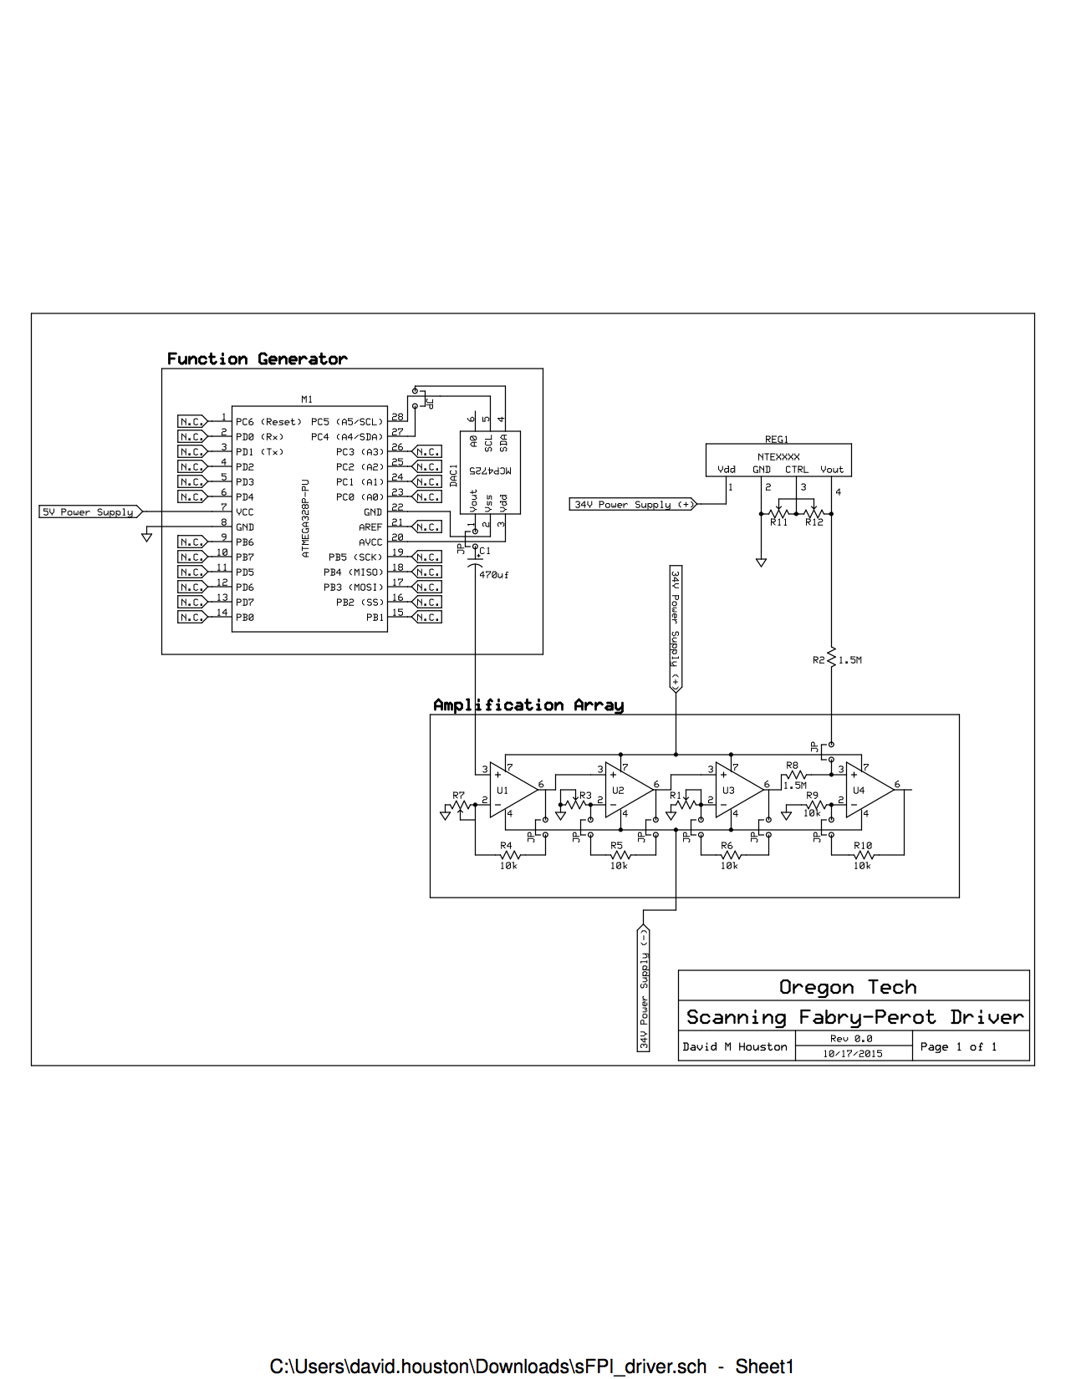
Electrical_Design/schematic-driver.jpg
