aviatorblue62/sFPI/Mechanical_Design/holder.jpg

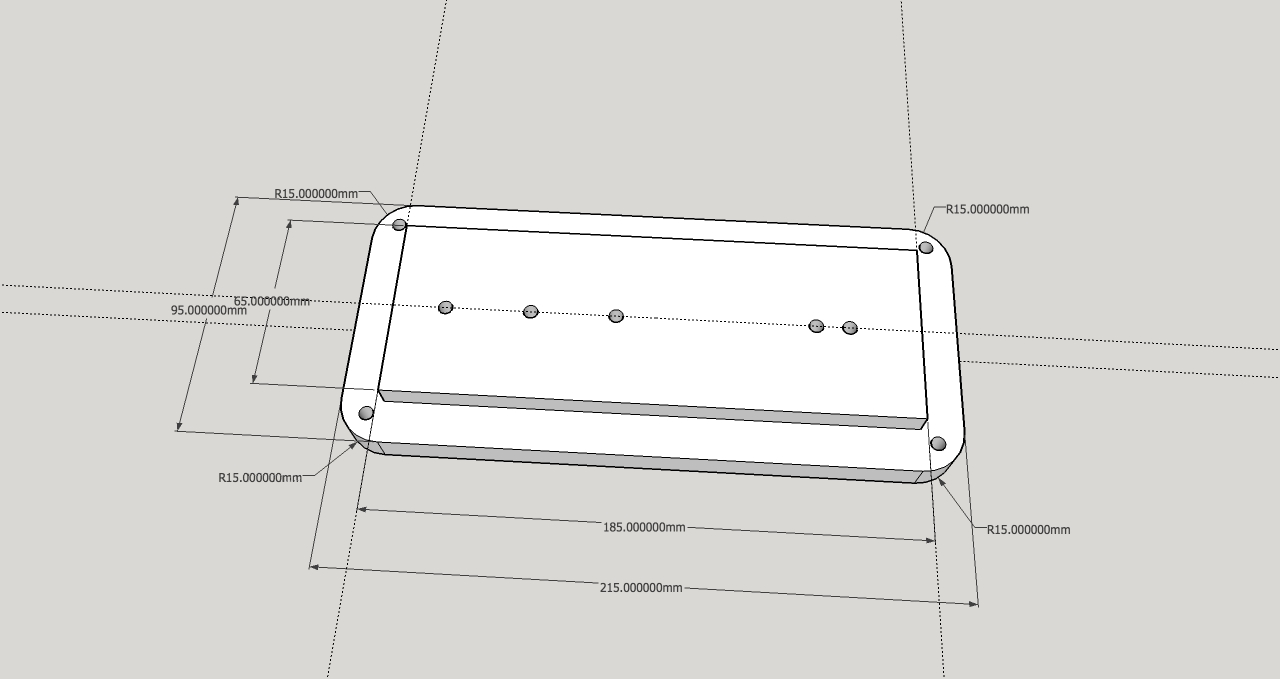
Mechanical_Design/holder.jpg
