aviatorblue62/sFPI/Mechanical_Design/PZT_holder.jpg

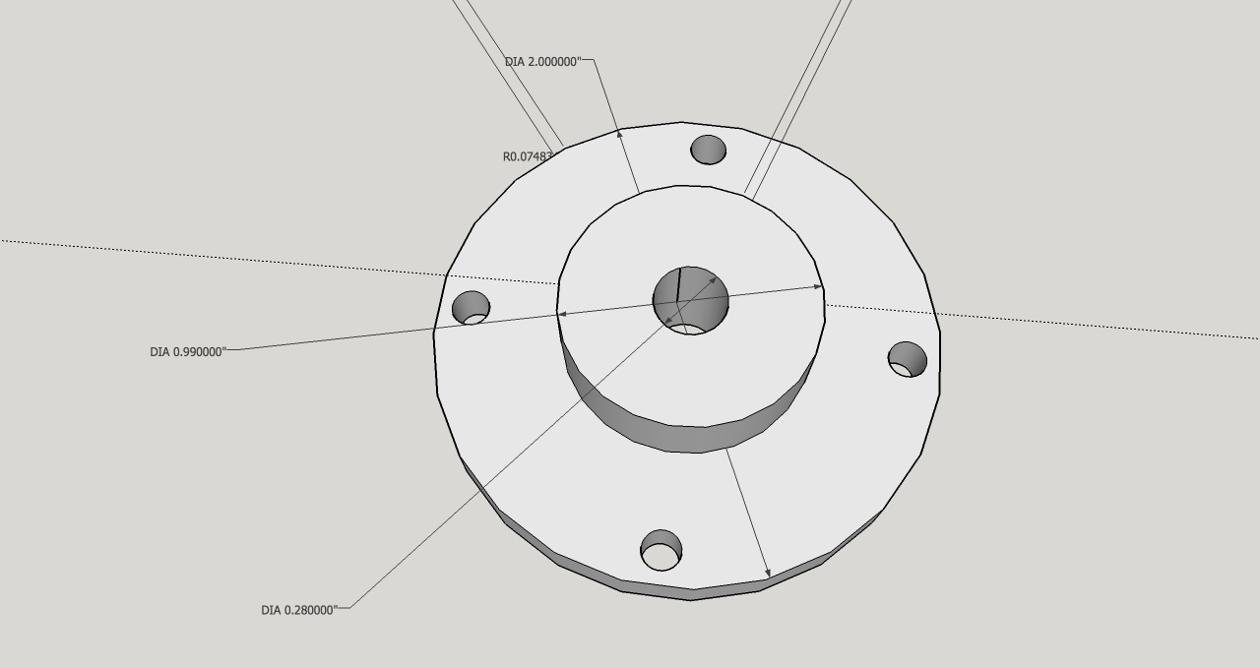
Mechanical_Design/PZT_holder.jpg
