aviatorblue62/sFPI/Mechanical_Design/sfpilensholder.jpg

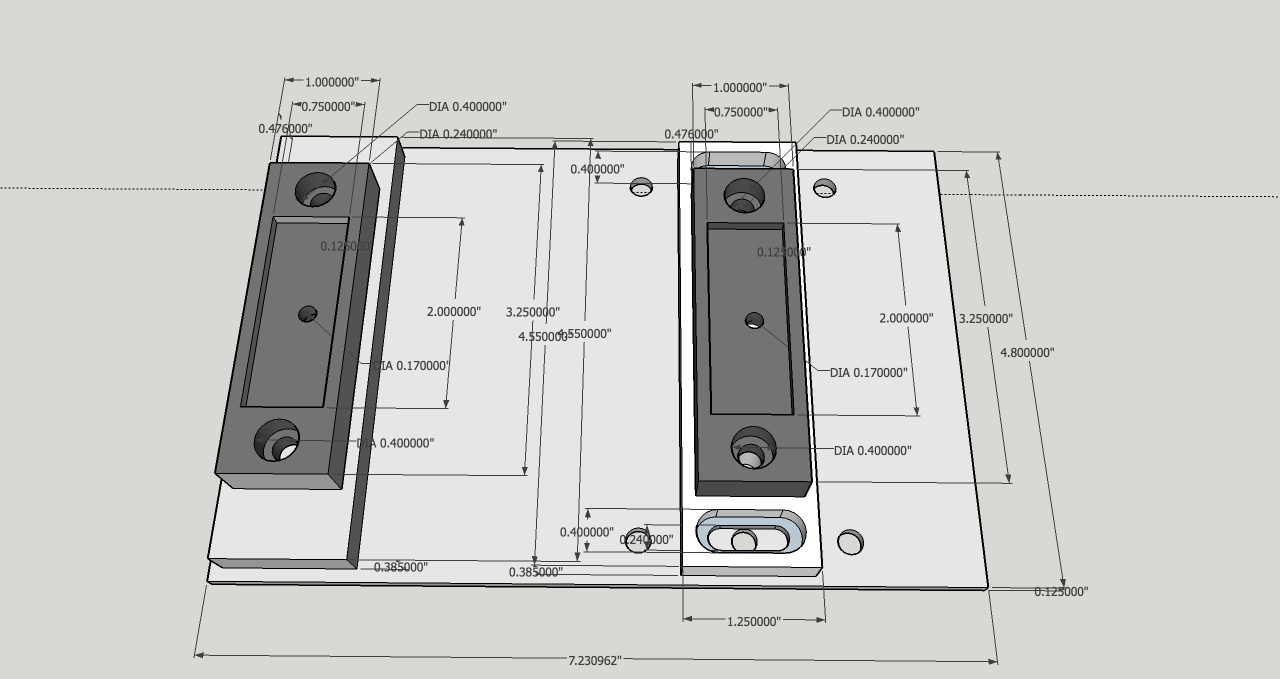
Mechanical_Design/sfpilensholder.jpg
