aviatorblue62/sFPI/PCB/data_processor.bmp

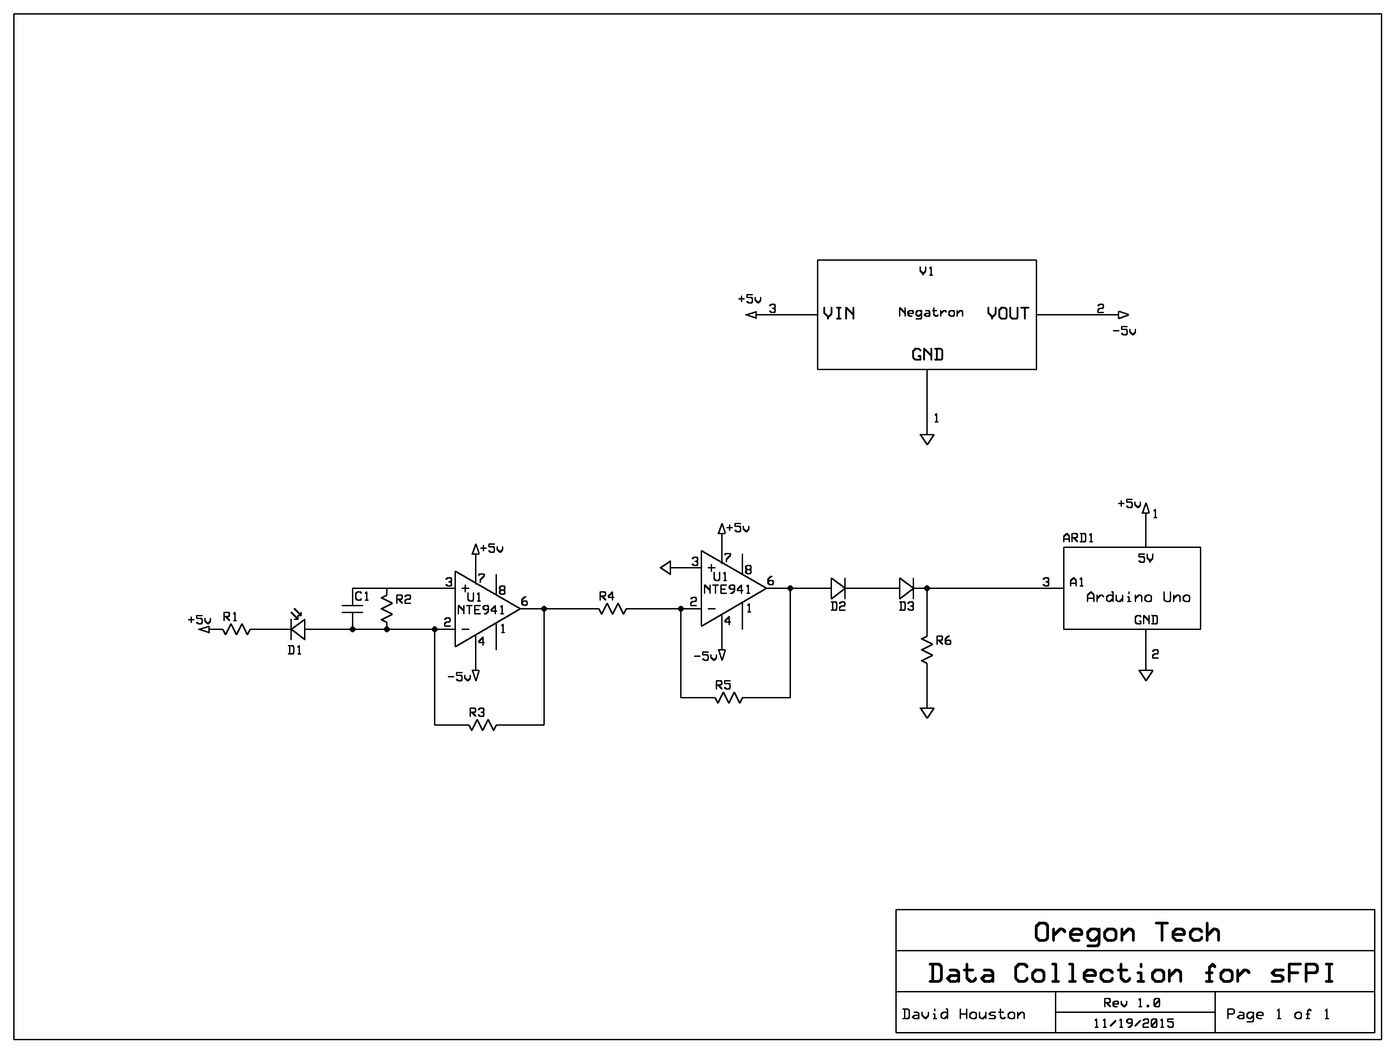
PCB/data_processor.bmp
