aviatorblue62/sFPI/PCB/sFPI_driver.bmp

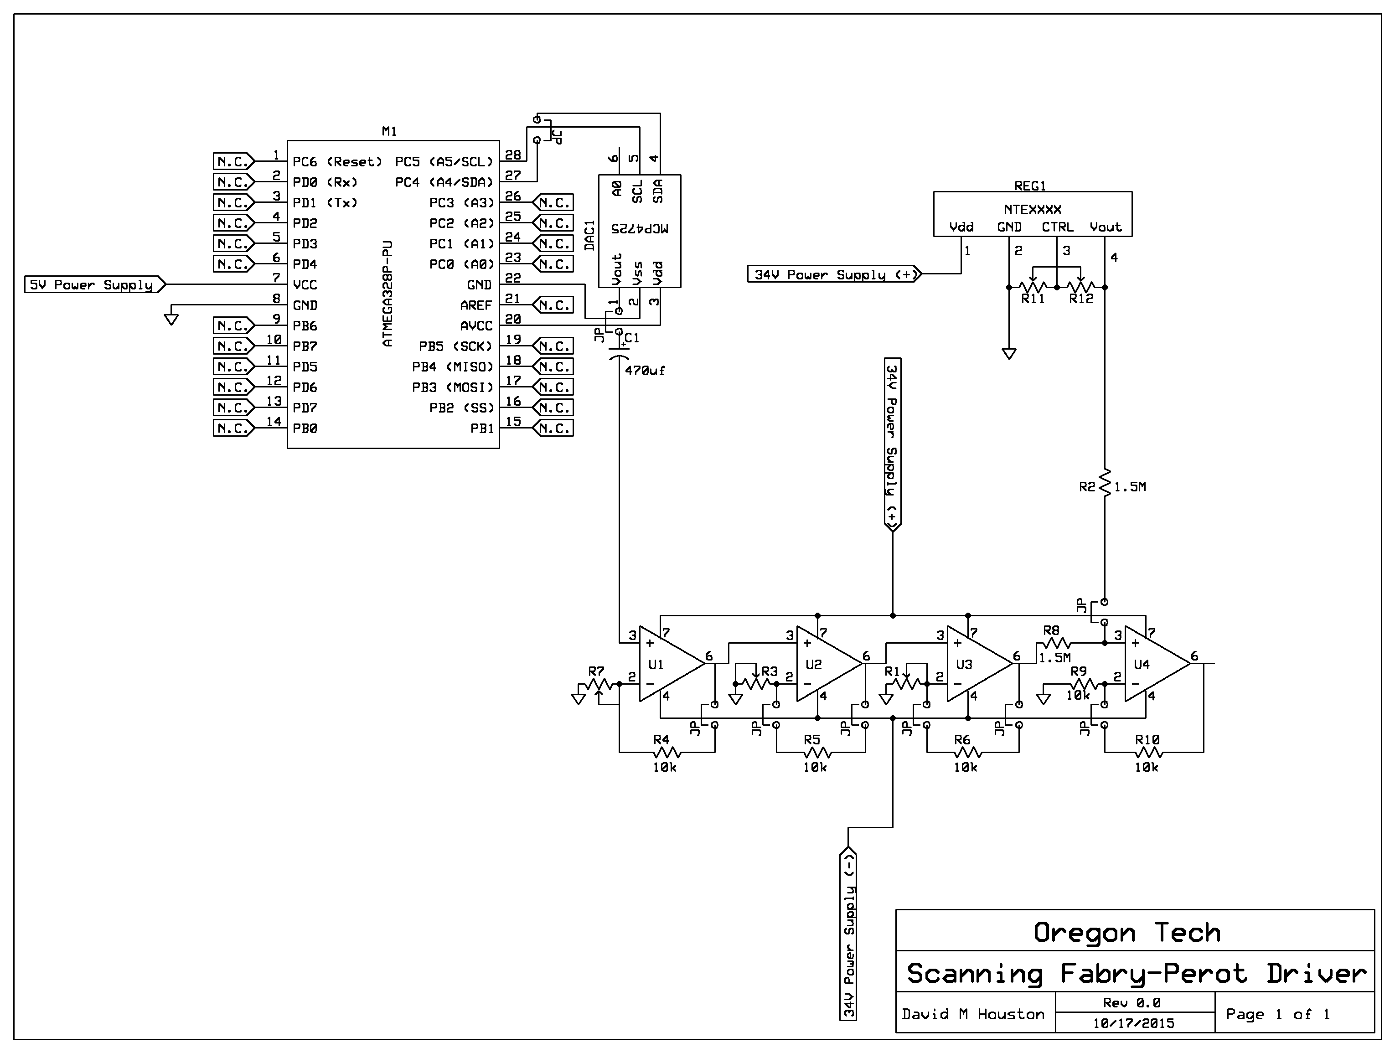
PCB/sFPI_driver.bmp
