aviatorblue62/sFPI/Presentation/driver.png

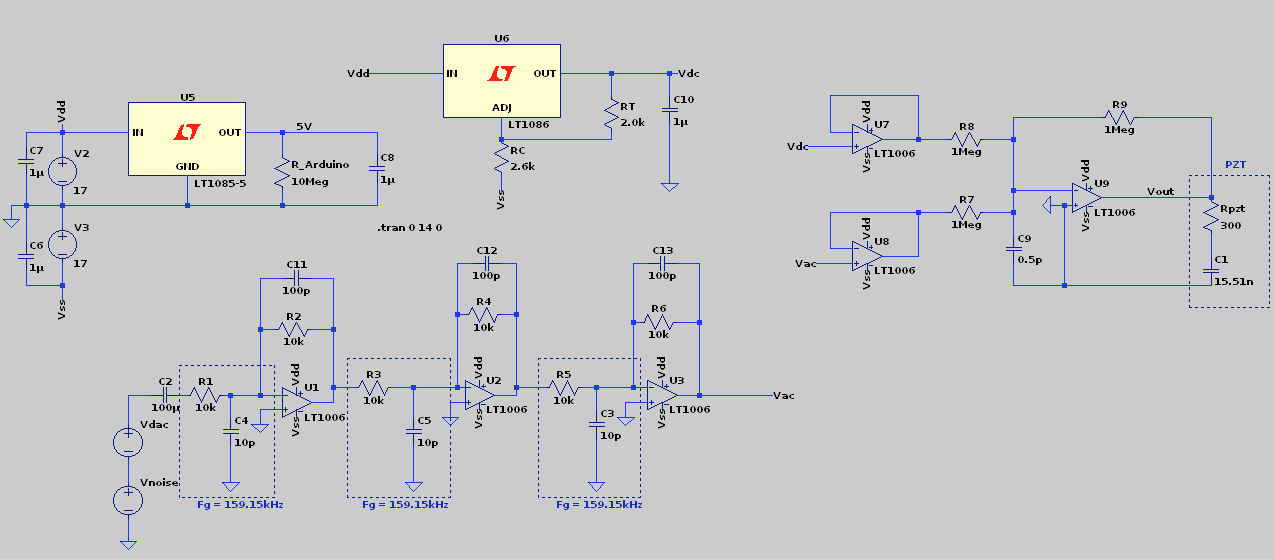
Presentation/driver.png
