aviatorblue62/sFPI/Presentation/lens1.png

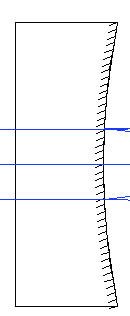
Presentation/lens1.png
