aviatorblue62/sFPI/Presentation/lens2.png

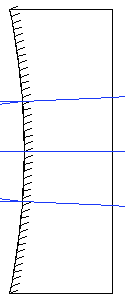
Presentation/lens2.png
