aviatorblue62/sFPI/Presentation/not_standing_wave.png

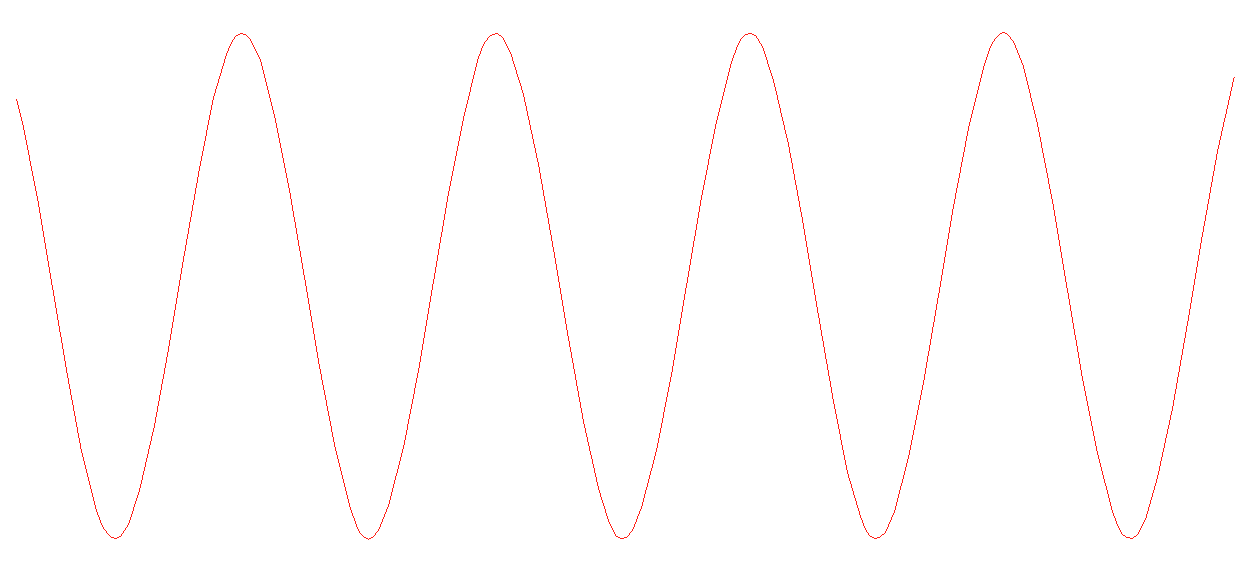
Presentation/not_standing_wave.png
