aviatorblue62/sFPI/Presentation/psin02512.jpg

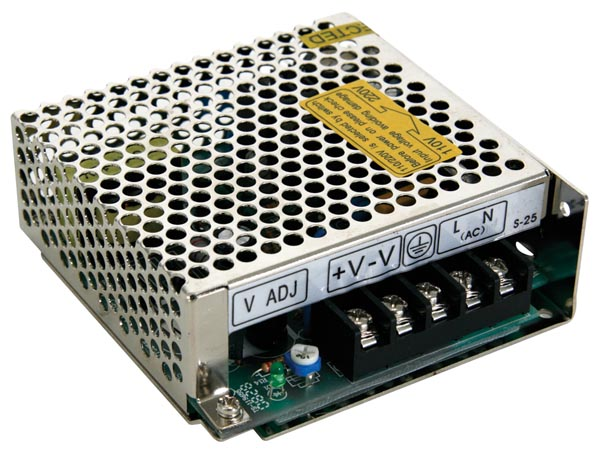
Presentation/psin02512.jpg
