aviatorblue62/sFPI/Presentation/wavelength.png

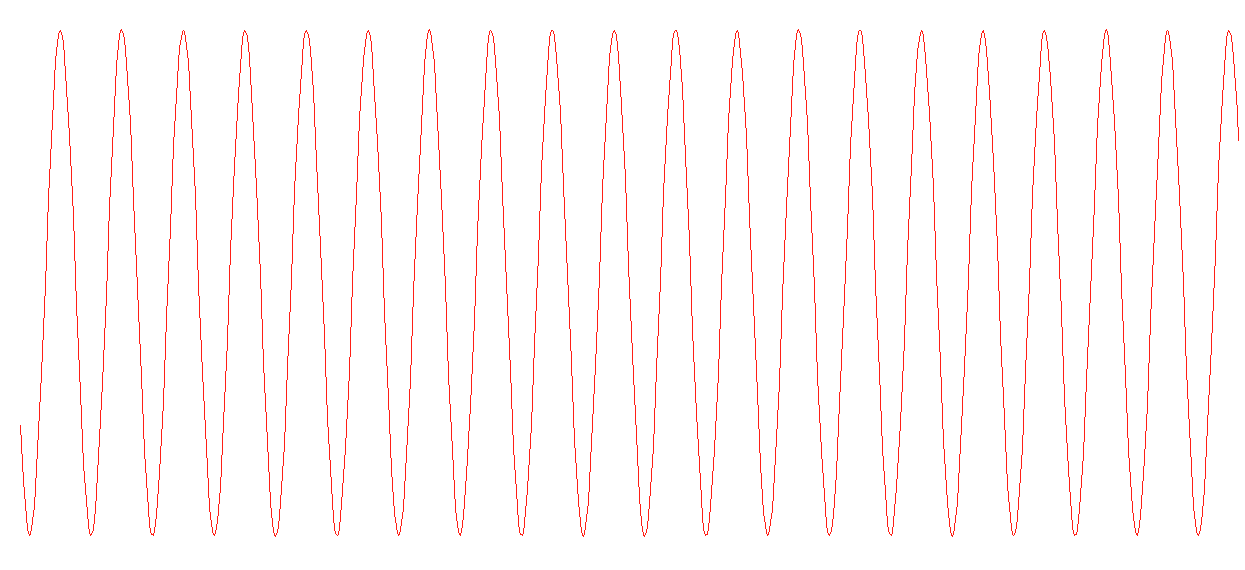
Presentation/wavelength.png
