aviatorblue62/sFPI/Program Design/fpsi_app/Graph.gif

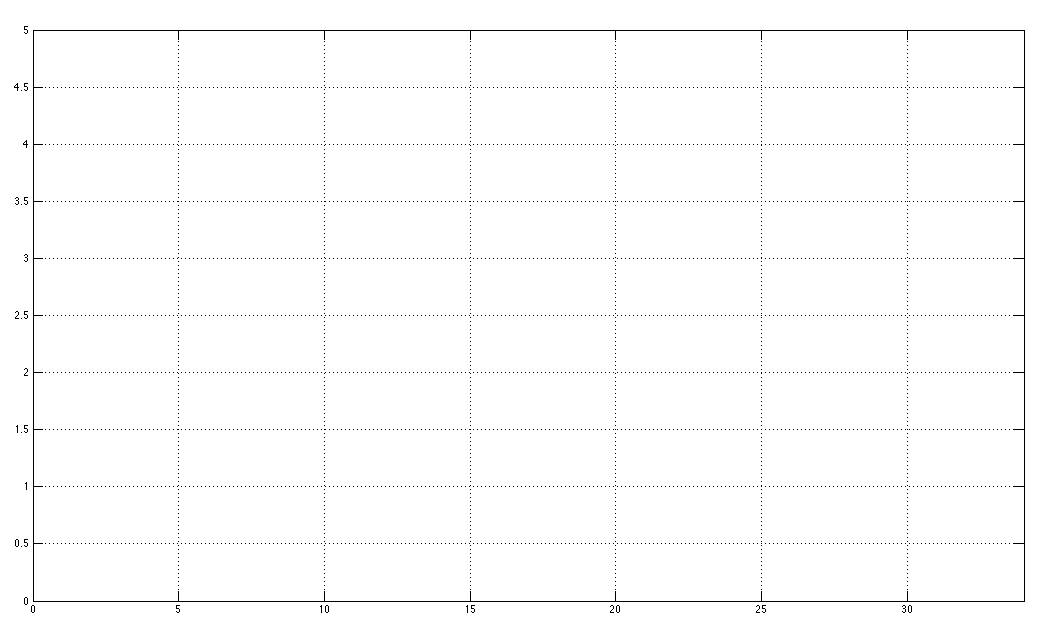
Program Design/fpsi_app/Graph.gif
