aviatorblue62/sFPI/Program Design/state_values_digital_input.png

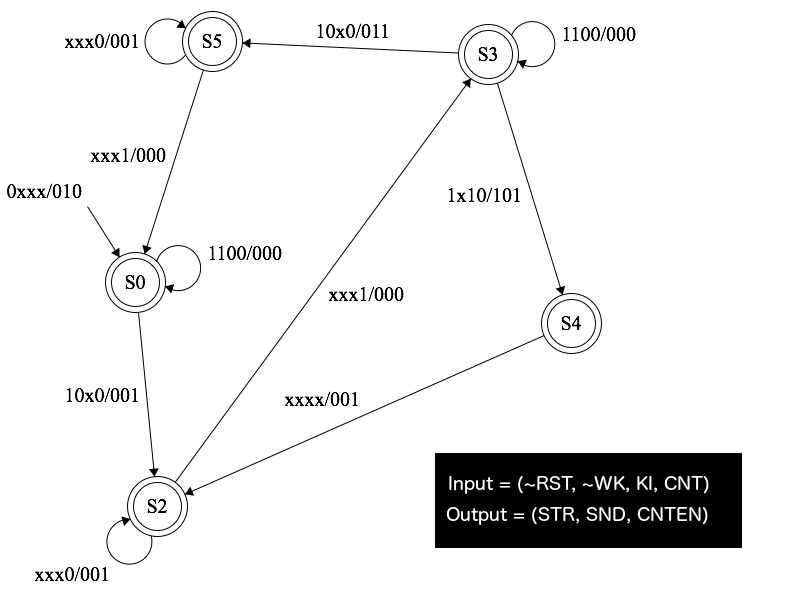
Program Design/state_values_digital_input.png
