aviatorblue62/sFPI/Thesis/images/Amplification-Array.png

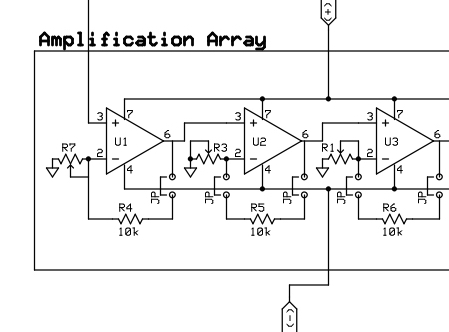
Thesis/images/Amplification-Array.png
