aviatorblue62/sFPI/Thesis/images/data/amplification_9v.bmp

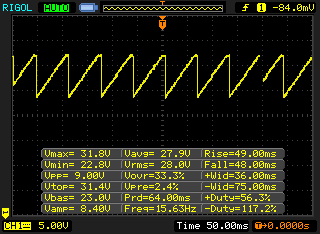
Thesis/images/data/amplification_9v.bmp
