aviatorblue62/sFPI/Thesis/images/data/max_amp_due_to_rails.bmp

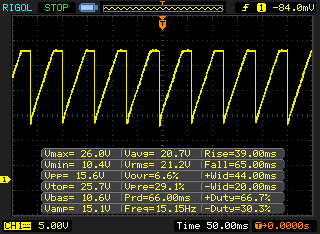
Thesis/images/data/max_amp_due_to_rails.bmp
