aviatorblue62/sFPI/Thesis/images/data/min_ramp.bmp

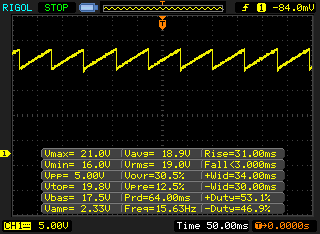
Thesis/images/data/min_ramp.bmp
