aviatorblue62/sFPI/Thesis/images/Etalon-2.png

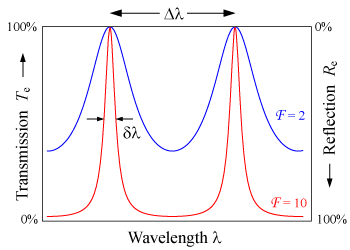
Thesis/images/Etalon-2.png
