aviatorblue62/sFPI/Thesis/images/fsr.png

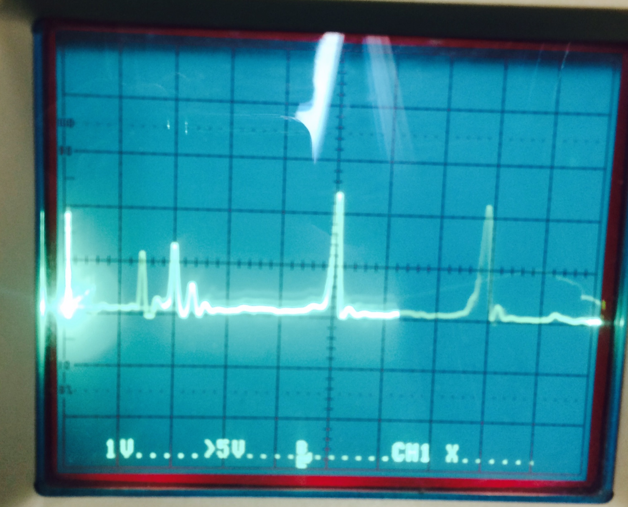
Thesis/images/fsr.png
