aviatorblue62/sFPI/Thesis/images/ltspice/adjustable-resistor-array.png

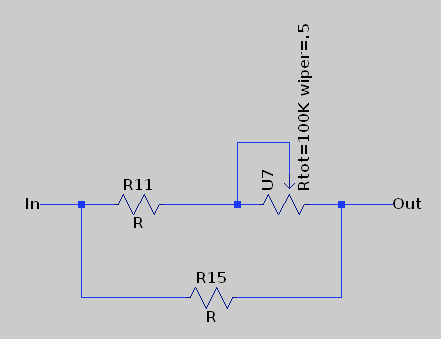
Thesis/images/ltspice/adjustable-resistor-array.png
