aviatorblue62/sFPI/Thesis/images/ltspice/driver-ltspice-model.png

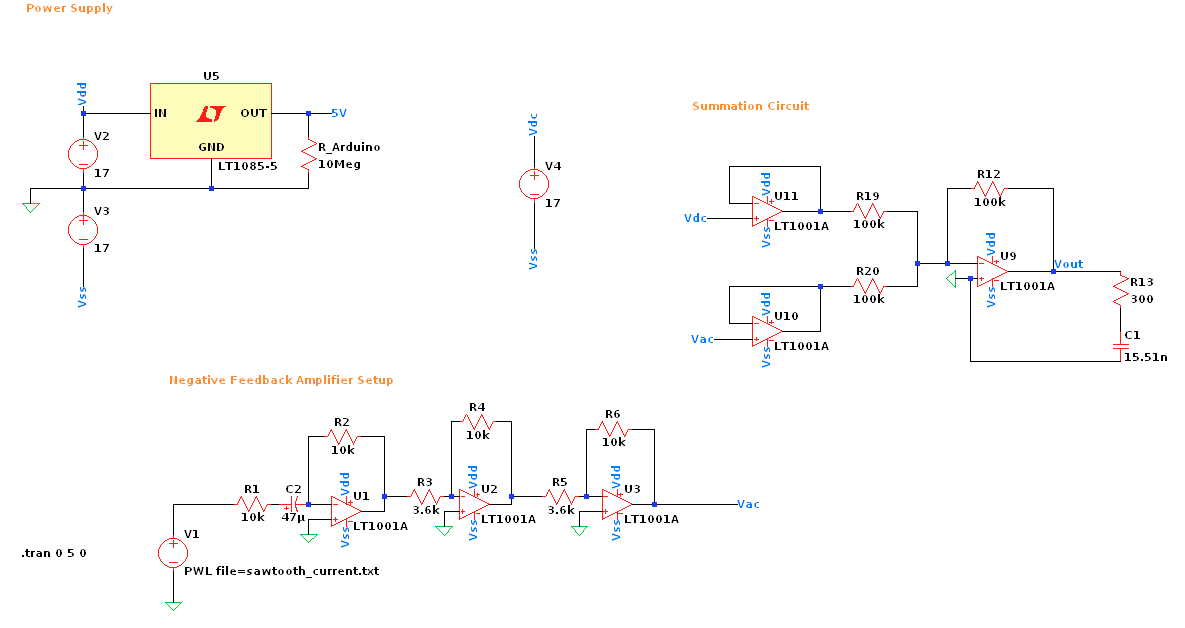
Thesis/images/ltspice/driver-ltspice-model.png
