aviatorblue62/sFPI/Thesis/images/ltspice/summation-circuit-design-ltspice.png

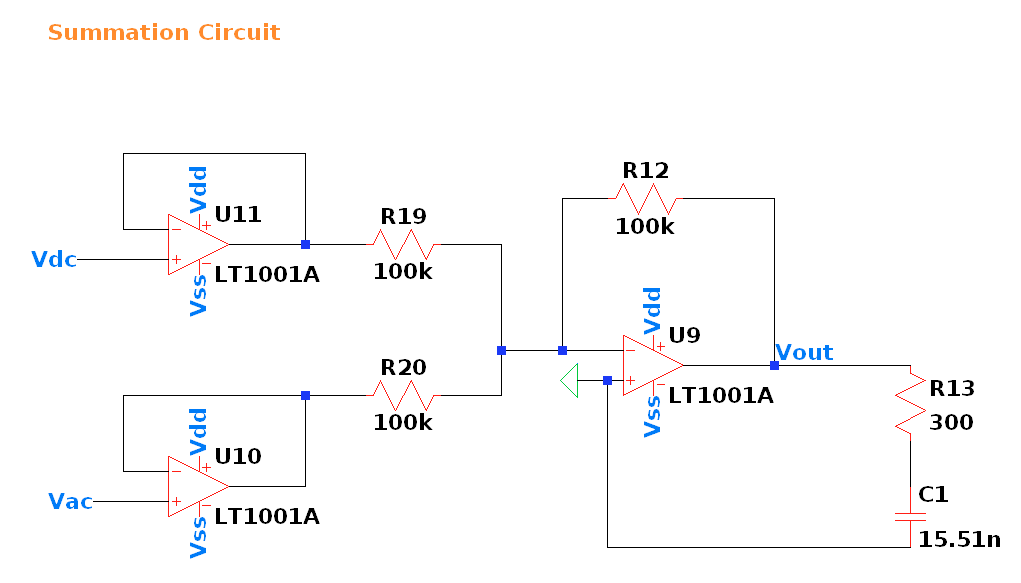
Thesis/images/ltspice/summation-circuit-design-ltspice.png
