aviatorblue62/sFPI/Thesis/images/non_ideal_amp.png

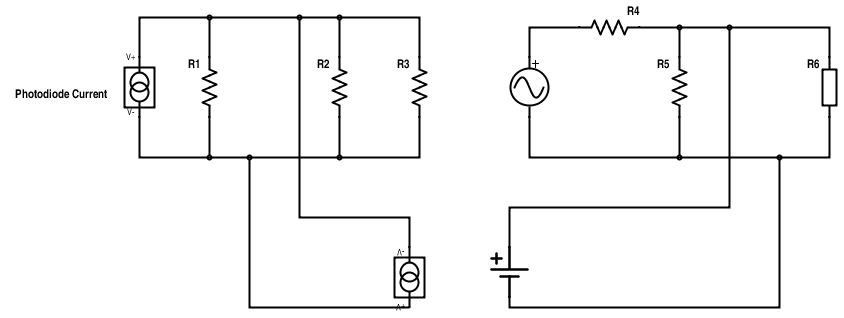
Thesis/images/non_ideal_amp.png
