aviatorblue62/sFPI/Thesis/images/ramp_function.png

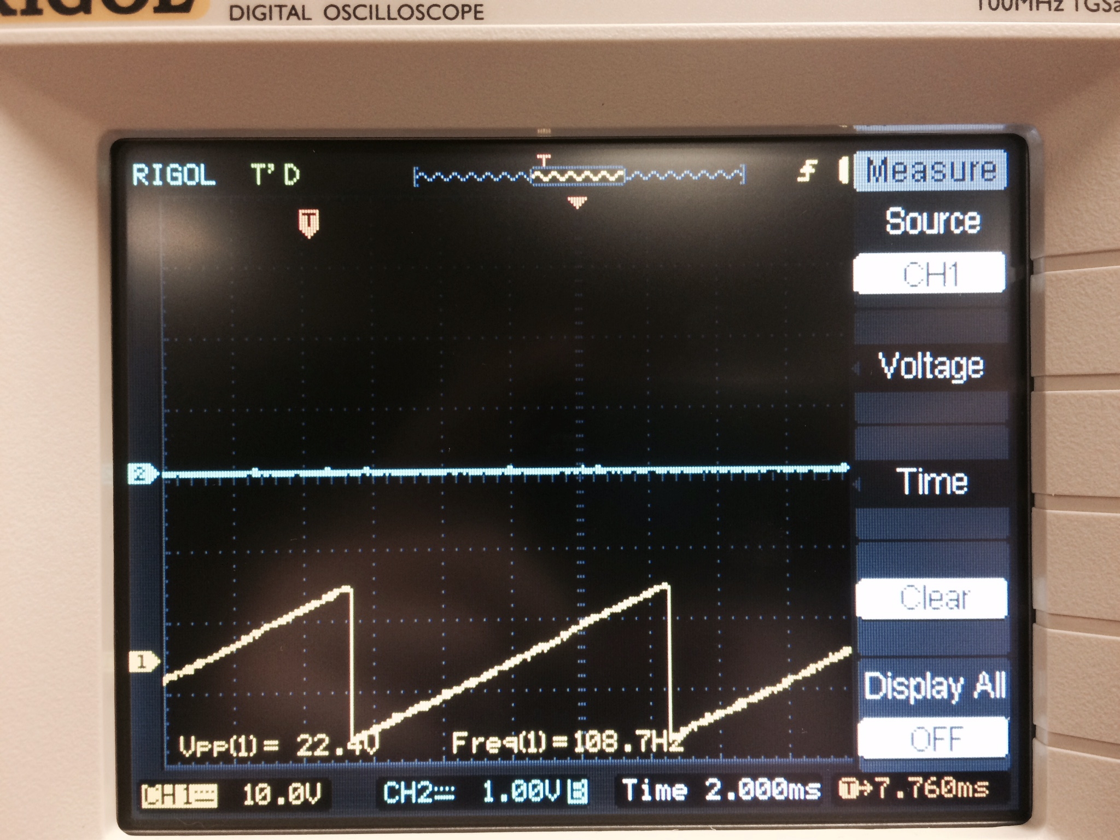
Thesis/images/ramp_function.png
