aviatorblue62/sFPI/Parts/Parts.xlsx

Sheet: Parts-Budget
Scanning Fabry-Perot Interferometer Parts List
 |  |  |  |  |  | TOTAL | $124.52
 | ITEM | Schematic | LABEL(S) | VALUE | Digikey | Datasheet | Price | COST
 | Capacitor | sFPI-Driver_Schematic | C1 | 3.3uF | 478-1891-ND (http://www.digikey.com/product-detail/en/TAP335K050SCS/478-1891-ND/563994) |  |  | $0.00
 | Capacitor | sFPI-Driver_Schematic | C2 | 100uF | 445-8441-ND (http://www.digikey.com/product-detail/en/FK20X5R0J107M/445-8441-ND/2815371) |  |  | $0.00
 | Capacitor | sFPI-Driver_Schematic | C3 | 1uF | 399-9886-1-ND (http://www.digikey.com/product-detail/en/C330C105K5R5TA7301/399-9886-1-ND/3726180) |  |  | $0.00
 | Capacitor | sFPI-Driver_Schematic | C4 | 1uF | 399-9886-1-ND (http://www.digikey.com/product-detail/en/C330C105K5R5TA7301/399-9886-1-ND/3726180) |  |  | $0.00
 | Capacitor | sFPI-Driver_Schematic | C5 | 22pF | 399-9721-ND (http://www.digikey.com/product-detail/en/C315C220J5G5TA/399-9721-ND/3726111) |  |  | $0.00
 | Capacitor | sFPI-Driver_Schematic | C6 | 22pF | 399-9721-ND (http://www.digikey.com/product-detail/en/C315C220J5G5TA/399-9721-ND/3726111) |  |  | $0.00
 | Capacitor | sFPI-Driver_Schematic | C7 | 22pF | 399-9721-ND |  |  | $0.00
 | Capacitor | sFPI-Driver_Schematic | C8 | 22pF | 399-9721-ND |  |  | $0.00
 | Capacitor | sFPI-Driver_Schematic | C9 | 22pF | 399-9721-ND |  |  | $0.00
 | Positive Adjustable Voltage Regulator | sFPI-Driver_Schematic | VR2 | 34V | LT3080EST#TRPBFCT-ND (http://www.digikey.com/product-detail/en/LT3080EST%23TRPBF/LT3080EST%23TRPBFCT-ND/1888449) | LT3080 | $4.22 | $4.22
 | Potentiometer | sFPI-Driver_Schematic | T1 | 100k | 93A1A-B28-A20L-ND (http://www.digikey.com/product-detail/en/93A1A-B28-A20L/93A1A-B28-A20L-ND/2564709) | BOURNS_91_95 | $5.88 | $5.88
 | Potentiometer | sFPI-Driver_Schematic | T2 | 10k | 83A1A-B24-J15L-ND (http://www.digikey.com/product-detail/en/83A1A-B24-J15L/83A1A-B24-J15L-ND/3534197) | BOURNS_83_84 | $34.32 | $34.32
 | Potentiometer | sFPI-Driver_Schematic | T3 | 10k | 83A1A-B24-J15L-ND (http://www.digikey.com/product-detail/en/83A1A-B24-J15L/83A1A-B24-J15L-ND/3534197) | BOURNS_83_84 | $34.32 | $34.32
 | Potentiometer | sFPI-Driver_Schematic | T4 | 5M | SPRU505C-ND (http://www.digikey.com/product-detail/en/SPRU5051S28/SPRU505C-ND/222775) | MIL Style RV8 | $10.64 | $10.64
 | Resistor | sFPI-Driver_Schematic | R2 | 10k | 10KADCT-ND (http://www.digikey.com/product-detail/en/MFP-25BRD52-10K/10KADCT-ND/2059114) |  |  | $0.00
 | Resistor | sFPI-Driver_Schematic | R5 | 3.3k | 3.3KADCT-ND (http://www.digikey.com/product-detail/en/MFP-25BRD52-3K3/3.3KADCT-ND/2059136) |  |  | $0.00
 | Resistor | sFPI-Driver_Schematic | R3 | 3.3k | 3.3KADCT-ND (http://www.digikey.com/product-detail/en/MFP-25BRD52-3K3/3.3KADCT-ND/2059136) |  |  | $0.00
 | Resistor | sFPI-Driver_Schematic | R4 | 10k | 10KADCT-ND (http://www.digikey.com/product-detail/en/MFP-25BRD52-10K/10KADCT-ND/2059114) |  |  | $0.00
 | Resistor | sFPI-Driver_Schematic | R6 | 10k | 10KADCT-ND (http://www.digikey.com/product-detail/en/MFP-25BRD52-10K/10KADCT-ND/2059114) |  |  | $0.00
 | Resistor | sFPI-Driver_Schematic | R7 | 1M | A105943CT-ND (http://www.digikey.com/product-detail/en/2-1676913-7/A105943CT-ND/3477511) |  |  | $0.00
 | Resistor | sFPI-Driver_Schematic | R8 | 1M | A105943CT-ND (http://www.digikey.com/product-detail/en/2-1676913-7/A105943CT-ND/3477511) |  |  | $0.00
 | Resistor | sFPI-Driver_Schematic | R9 | 1M | A105943CT-ND |  |  | $0.00
 | Resistor | sFPI-Driver_Schematic | R10 | 10k | 10KADCT-ND (http://www.digikey.com/product-detail/en/MFP-25BRD52-10K/10KADCT-ND/2059114) |  | $2.22 | $2.22
 | Positive Adjustable Voltage Regulator | sFPI-Driver_Schematic | VR1 | 5V | LT1129CS8-5#PBF-ND (http://www.digikey.com/product-detail/en/LT1129CS8-5%23PBF/LT1129CS8-5%23PBF-ND/891901) | LT1129-5 | $5.03 | $5.03
 | ATMEGA168P | sFPI-Driver_Schematic | IC1 | ARDUINO | ATMEGA168PA-PU-ND (http://www.digikey.com/product-detail/en/ATMEGA168PA-PU/ATMEGA168PA-PU-ND/1914551) | ATMEGA168P | $3.26 | $3.26
 | MCP4725 | sFPI-Driver_Schematic | DAC1 | 5V | MCP4725A0T-E/CHCT-ND (http://www.digikey.com/product-detail/en/MCP4725A0T-E%2FCH/MCP4725A0T-E%2FCHCT-ND/1817328) | MCP4725 | $0.96 | $0.96
 | 16 MHZ CLOCK | sFPI-Driver_Schematic | QF1 | 16MHz | CTX1085-ND (http://www.digikey.com/product-detail/en/ATS16B/CTX1085-ND/2640031) | CTS_008-0309-0 | $0.36 | $0.36
 | Operational Amplifier | sFPI-Driver_Schematic | U1 | OPAMP | LT1006CN8#PBF-ND (http://www.digikey.com/scripts/DkSearch/dksus.dll?Detail&itemSeq=187563128&uq=635897861902484643) | LT1006 | $3.12 | $3.12
 | Operational Amplifier | sFPI-Driver_Schematic | U2 | OPAMP | LT1006CN8#PBF-ND (http://www.digikey.com/scripts/DkSearch/dksus.dll?Detail&itemSeq=187563128&uq=635897861902484643) | LT1006 | $3.12 | $3.12
 | Operational Amplifier | sFPI-Driver_Schematic | U3 | OPAMP | LT1006CN8#PBF-ND (http://www.digikey.com/scripts/DkSearch/dksus.dll?Detail&itemSeq=187563128&uq=635897861902484643) | LT1006 | $3.12 | $3.12
 | Operational Amplifier | sFPI-Driver_Schematic | U4 | OPAMP | LT1006CN8#PBF-ND (http://www.digikey.com/scripts/DkSearch/dksus.dll?Detail&itemSeq=187563128&uq=635897861902484643) | LT1006 | $3.12 | $3.12
 | Operational Amplifier | sFPI-Driver_Schematic | U5 | OPAMP | LT1006CN8#PBF-ND (http://www.digikey.com/scripts/DkSearch/dksus.dll?Detail&itemSeq=187563128&uq=635897861902484643) | LT1006 | $3.12 | $3.12
 | Operational Amplifier | sFPI-Driver_Schematic | U6 | OPAMP | LT1006CN8#PBF-ND (http://www.digikey.com/scripts/DkSearch/dksus.dll?Detail&itemSeq=187563128&uq=635897861902484643) | LT1006 | $3.12 | $3.12
 | Precision, Very Low Noise, Low Input Bias Current, Operational Amplifiers | sFPI-Photodiode_Schematic | U1 | OPAMP | AD8672ARMZ-REELCT-ND (https://www.digikey.com/product-detail/en/AD8672ARMZ-REEL/AD8672ARMZ-REELCT-ND/1957836) | AD8672 | $4.59 | $4.59
 | Capacitor | sFPI-Photodiode_Schematic | C1 | 47pF | 399-9738-ND (http://www.digikey.com/product-detail/en/C315C470K1G5TA/399-9738-ND/3725999) |  |  | $0.00
 | Capacitor | sFPI-Photodiode_Schematic | C2 | 68nF | 399-4194-ND (http://www.digikey.com/product-detail/en/C315C682K5R5TA/399-4194-ND/817970) |  |  | $0.00
 | Capacitor | sFPI-Photodiode_Schematic | C4 | 100pF | 399-4200-ND (http://www.digikey.com/product-detail/en/C317C101K2R5TA/399-4200-ND/817976) |  |  | $0.00
 | Capacitor | sFPI-Photodiode_Schematic | C3 | 10p | 1246PH-ND (http://www.digikey.com/product-detail/en/S100K25SL0N63L6R/1246PH-ND/2356783) |  |  | $0.00
 | Trimm Potentiometer | sFPI-Photodiode_Schematic | R1 | 10k | 3386P-103LF-ND (http://www.digikey.com/product-detail/en/3386P-1-103LF/3386P-103LF-ND/1088523) | BOURNS_3386 |  | $0.00
 | Resistor | sFPI-Photodiode_Schematic | R2_bias | 10Meg | 10MGACT-ND (http://www.digikey.com/product-detail/en/HHV-25FR-52-10M/10MGACT-ND/2813158) |  |  | $0.00
 | Trimm Potentiometer | sFPI-Photodiode_Schematic | R2_trimm | 4Meg | CT6EP205-ND (http://www.digikey.com/product-detail/en/CT6EP205/CT6EP205-ND/738311) | ct-6 |  | $0.00
 | Resistor | sFPI-Photodiode_Schematic | R3_bias | 50k | 696-1564-ND (http://www.digikey.com/product-detail/en/101-50KX/696-1564-ND/4832948) |  |  | $0.00
 | Trimm Potentiometer | sFPI-Photodiode_Schematic | R3_trimm | 100k | 987-1335-ND (http://www.digikey.com/product-detail/en/P260T-D1BS3CB100K/987-1335-ND/2408912) | p260 |  | $0.00
 | Resistor | sFPI-Photodiode_Schematic | R4_bias_1 | 10Meg | 10MGACT-ND (http://www.digikey.com/product-detail/en/HHV-25FR-52-10M/10MGACT-ND/2813158) |  |  | $0.00
 | Resistor | sFPI-Photodiode_Schematic | R4_bias_2 | 2Meg | CF14JT2M00CT-ND (http://www.digikey.com/product-detail/en/CF14JT2M00/CF14JT2M00CT-ND/1830429) |  |  | $0.00
 | Trimm Potentiometer | sFPI-Photodiode_Schematic | R4_trimm | 4Meg | CT6EP205-ND (http://www.digikey.com/product-detail/en/CT6EP205/CT6EP205-ND/738311) | ct-6 |  | $0.00
 | Resistor | sFPI-Photodiode_Schematic | R5 | 10Meg | 10MGACT-ND (http://www.digikey.com/product-detail/en/HHV-25FR-52-10M/10MGACT-ND/2813158) |  |  | $0.00
 | Diode | sFPI-Photodiode_Schematic | D1 |  | ON HAND |  |  | $0.00
 |  | sFPI-Power-Supply_Schematic |  |  |  |  |  | $0.00
 |  |  |  |  |  |  |  | $0.00
 |  |  |  |  |  |  |  | $0.00
 |  |  |  |  |  |  |  | $0.00
 |  |  |  |  |  |  |  | $0.00
 |  |  |  |  |  |  |  | $0.00
 |  |  |  |  |  |  |  | $0.00
 |  |  |  |  |  |  |  | $0.00
 |  |  |  |  |  |  |  | $0.00
 |  |  |  |  |  |  |  | $0.00
 |  |  |  |  |  |  |  | $0.00
 |  |  |  |  |  |  |  | $0.00
 | Total |  |  |  |  |  |  | $124.52

Sheet: Driver - BOM - 02.13.2016
ndex | Quantity | Image | Part Number | Description | Customer Reference | Available Quantity | Backorder Quantity | Unit Price | Extended Price
1 | 2 |  | 83A1A-B24-J15L-ND (http://www.digikey.com/scripts/DkSearch/dksus.dll?Detail&itemSeq=189882886&uq=635910173990351891) | POT 10K OHM 1W WIREWOUND LINEAR |  | 2 | 0 | 34.32 | $68.64
 |  |  |  |  |  | Immediate
2 | 1 |  | 93A1A-B28-A20L-ND (http://www.digikey.com/scripts/DkSearch/dksus.dll?Detail&itemSeq=189882903&uq=635910173990351891) | POT 100K OHM 2W CERMET LINEAR |  | 1 | 0 | 5.88 | $5.88
 |  |  |  |  |  | Immediate
3 | 1 |  | LT3080EST#TRPBFCT-ND (http://www.digikey.com/scripts/DkSearch/dksus.dll?Detail&itemSeq=189882927&uq=635910173990361891) | IC REG LDO ADJ 1.1A SOT223 |  | 1 | 0 | 4.22 | $4.22
 |  |  |  |  |  | Immediate
4 | 5 |  | 445-173485-1-ND (http://www.digikey.com/scripts/DkSearch/dksus.dll?Detail&itemSeq=189882947&uq=635910173990361891) | CAP CER 22PF 50V C0G RADIAL |  | 5 | 0 | 0.28 | $1.40
 |  |  |  |  |  | Immediate
5 | 4 |  | RNCF1206TKY10K0CT-ND (http://www.digikey.com/scripts/DkSearch/dksus.dll?Detail&itemSeq=189882955&uq=635910173990361891) | RES SMD 10K OHM 0.01% 1/4W 1206 |  | 4 | 0 | 2.22 | $8.88
 |  |  |  |  |  | Immediate
6 | 1 |  | 478-3866-1-ND (http://www.digikey.com/scripts/DkSearch/dksus.dll?Detail&itemSeq=189882962&uq=635910173990371891) | CAP TANT 3.3UF 10V 10% 1206 |  | 1 | 0 | 0.53 | $0.53
 |  |  |  |  |  | Immediate
7 | 1 |  | SPRU505C-ND (http://www.digikey.com/scripts/DkSearch/dksus.dll?Detail&itemSeq=189882969&uq=635910173990371891) | POT 5M OHM 1/2W CARBON LINEAR |  | 1 | 0 | 10.64 | $10.64
 |  |  |  |  |  | Immediate
8 | 2 |  | 311-3.30KFRCT-ND (http://www.digikey.com/scripts/DkSearch/dksus.dll?Detail&itemSeq=189882982&uq=635910173990371891) | RES SMD 3.3K OHM 1% 1/4W 1206 |  | 2 | 0 | 0.1 | $0.20
 |  |  |  |  |  | Immediate
9 | 3 |  | RNCF1206BKE1M00CT-ND (http://www.digikey.com/scripts/DkSearch/dksus.dll?Detail&itemSeq=189882991&uq=635910173990381891) | RES SMD 1M OHM 0.1% 1/4W 1206 |  | 3 | 0 | 0.59 | $1.77
 |  |  |  |  |  | Immediate
10 | 1 |  | LT1129CS8-5#PBF-ND (http://www.digikey.com/scripts/DkSearch/dksus.dll?Detail&itemSeq=189883024&uq=635910173990381891) | IC REG LDO 5V 0.7A 8SOIC |  | 1 | 0 | 4.77 | $4.77
 |  |  |  |  |  | Immediate
11 | 1 |  | MCP4725A0T-E/CHCT-ND (http://www.digikey.com/scripts/DkSearch/dksus.dll?Detail&itemSeq=189883046&uq=635910173990381891) | IC DAC 12BIT W/I2C SOT23A-6 |  | 1 | 0 | 0.96 | $0.96
 |  |  |  |  |  | Immediate
12 | 1 |  | CTX1085-ND (http://www.digikey.com/scripts/DkSearch/dksus.dll?Detail&itemSeq=189883051&uq=635910173990391891) | CRYSTAL 16.0000MHZ 18PF T/H |  | 1 | 0 | 0.36 | $0.36
 |  |  |  |  |  | Immediate
13 | 2 |  | 490-7516-1-ND (http://www.digikey.com/scripts/DkSearch/dksus.dll?Detail&itemSeq=189883084&uq=635910173990391891) | CAP CER 1UF 50V X7R RADIAL |  | 2 | 0 | 0.82 | $1.64
 |  |  |  |  |  | Immediate

Sheet: sFPI - BOM - 02.22.2016
Index | Quantity | Image | Part Number | Description | Customer Reference | Available Quantity | Backorder Quantity | Unit Price | Extended Price
1 |  |  | 478-1891-ND (http://www.digikey.com/scripts/DkSearch/dksus.dll?Detail&itemSeq=190609998&uq=635918542216195847) | CAP TANT 3.3UF 50V 10% RADIAL |  | 2 | 0 | 1.1 | $2.20
 |  |  |  |  |  | Immediate
2 |  |  | 445-8441-ND (http://www.digikey.com/scripts/DkSearch/dksus.dll?Detail&itemSeq=190610007&uq=635918542216195847) | CAP CER 100UF 6.3V X5R RADIAL |  | 2 | 0 | 0.95 | $1.90
 |  |  |  |  |  | Immediate
3 |  |  | 399-9886-1-ND (http://www.digikey.com/scripts/DkSearch/dksus.dll?Detail&itemSeq=190610019&uq=635918542216195847) | CAP CER 1UF 50V X7R RADIAL |  | 3 | 0 | 1.47 | $4.41
 |  |  |  |  |  | Immediate
4 |  |  | 399-9721-ND (http://www.digikey.com/scripts/DkSearch/dksus.dll?Detail&itemSeq=190610045&uq=635918542216195847) | CAP CER 22PF 50V NP0 RADIAL |  | 10 | 0 | 0.292 | $2.92
 |  |  |  |  |  | Immediate
5 |  |  | LT3080EST#TRPBFCT-ND (http://www.digikey.com/scripts/DkSearch/dksus.dll?Detail&itemSeq=190610067&uq=635918542216195847) | IC REG LDO ADJ 1.1A SOT223 |  | 2 | 0 | 4.22 | $8.44
 |  |  |  |  |  | Immediate
6 |  |  | 93A1A-B28-A20L-ND (http://www.digikey.com/scripts/DkSearch/dksus.dll?Detail&itemSeq=190610075&uq=635918542216195847) | POT 100K OHM 2W CERMET LINEAR |  | 2 | 0 | 5.88 | $11.76
 |  |  |  |  |  | Immediate
7 |  |  | 83A1A-B24-J15L-ND (http://www.digikey.com/scripts/DkSearch/dksus.dll?Detail&itemSeq=190610084&uq=635918542216205847) | POT 10K OHM 1W WIREWOUND LINEAR |  | 2 | 0 | 34.32 | $68.64
 |  |  |  |  |  | Immediate
8 |  |  | SPRU505C-ND (http://www.digikey.com/scripts/DkSearch/dksus.dll?Detail&itemSeq=190610099&uq=635918542216205847) | POT 5M OHM 1/2W CARBON LINEAR |  | 1 | 0 | 10.64 | $10.64
 |  |  |  |  |  | Immediate
9 |  |  | 10KADCT-ND (http://www.digikey.com/scripts/DkSearch/dksus.dll?Detail&itemSeq=190610132&uq=635918542216205847) | RES 10K OHM 1/4W 0.1% AXIAL |  | 10 | 0 | 0.356 | $3.56
 |  |  |  |  |  | Immediate
10 |  |  | 3.3KADCT-ND (http://www.digikey.com/scripts/DkSearch/dksus.dll?Detail&itemSeq=190610144&uq=635918542216205847) | RES 3.3K OHM 1/4W 0.1% AXIAL |  | 10 | 0 | 0.356 | $3.56
 |  |  |  |  |  | Immediate
11 |  |  | A105943CT-ND (http://www.digikey.com/scripts/DkSearch/dksus.dll?Detail&itemSeq=190610150&uq=635918542216205847) | RES 1.00M OHM 1/4W 0.1% AXIAL |  | 5 | 0 | 0.45 | $2.25
 |  |  |  |  |  | Immediate
12 |  |  | LT1129CS8-5#PBF-ND (http://www.digikey.com/scripts/DkSearch/dksus.dll?Detail&itemSeq=190610159&uq=635918542216205847) | IC REG LDO 5V 0.7A 8SOIC |  | 2 | 0 | 4.77 | $9.54
 |  |  |  |  |  | Immediate
13 |  |  | MCP4725A0T-E/CHCT-ND (http://www.digikey.com/scripts/DkSearch/dksus.dll?Detail&itemSeq=190610177&uq=635918542216205847) | IC DAC 12BIT W/I2C SOT23A-6 |  | 4 | 0 | 0.96 | $3.84
 |  |  |  |  |  | Immediate
14 |  |  | CTX1085-ND (http://www.digikey.com/scripts/DkSearch/dksus.dll?Detail&itemSeq=190610192&uq=635918542216205847) | CRYSTAL 16.0000MHZ 18PF T/H |  | 5 | 0 | 0.36 | $1.80
 |  |  |  |  |  | Immediate
15 |  |  | LT1006CN8#PBF-ND (http://www.digikey.com/scripts/DkSearch/dksus.dll?Detail&itemSeq=190610206&uq=635918542216205847) | IC OPAMP GP 8DIP |  | 6 | 0 | 3.12 | $18.72
 |  |  |  |  |  | Immediate
16 |  |  | AD8672ARMZ-REELCT-ND (http://www.digikey.com/scripts/DkSearch/dksus.dll?Detail&itemSeq=190610211&uq=635918542216215847) | IC OPAMP GP 10MHZ 8MSOP |  | 2 | 0 | 4.59 | $9.18
 |  |  |  |  |  | Immediate
17 |  |  | 399-9738-ND (http://www.digikey.com/scripts/DkSearch/dksus.dll?Detail&itemSeq=190610223&uq=635918542216215847) | CAP CER 47PF 100V NP0 RADIAL |  | 10 | 0 | 0.259 | $2.59
 |  |  |  |  |  | Immediate
18 |  |  | 399-4194-ND (http://www.digikey.com/scripts/DkSearch/dksus.dll?Detail&itemSeq=190610230&uq=635918542216215847) | CAP CER 6800PF 50V X7R RADIAL |  | 10 | 0 | 0.22 | $2.20
 |  |  |  |  |  | Immediate
19 |  |  | 399-4200-ND (http://www.digikey.com/scripts/DkSearch/dksus.dll?Detail&itemSeq=190610235&uq=635918542216215847) | CAP CER 100PF 200V X7R RADIAL |  | 10 | 0 | 0.235 | $2.35
 |  |  |  |  |  | Immediate
20 |  |  | 1246PH-ND (http://www.digikey.com/scripts/DkSearch/dksus.dll?Detail&itemSeq=190610247&uq=635918542216215847) | CAP CER 10PF 1KV SL RADIAL |  | 10 | 0 | 0.214 | $2.14
 |  |  |  |  |  | Immediate
21 |  |  | 3386P-103LF-ND (http://www.digikey.com/scripts/DkSearch/dksus.dll?Detail&itemSeq=190610260&uq=635918542216215847) | TRIMMER 10K OHM 0.5W PC PIN |  | 3 | 0 | 1.6 | $4.80
 |  |  |  |  |  | Immediate
22 |  |  | 10MGACT-ND (http://www.digikey.com/scripts/DkSearch/dksus.dll?Detail&itemSeq=190610274&uq=635918542216215847) | RES 10M OHM 1/4W 1% AXIAL |  | 10 | 0 | 0.319 | $3.19
 |  |  |  |  |  | Immediate
23 |  |  | CT6EP205-ND (http://www.digikey.com/scripts/DkSearch/dksus.dll?Detail&itemSeq=190610284&uq=635918542216215847) | TRIMMER 2M OHM 0.5W TH |  | 4 | 0 | 0.79 | $3.16
 |  |  |  |  |  | Immediate
24 |  |  | 696-1564-ND (http://www.digikey.com/scripts/DkSearch/dksus.dll?Detail&itemSeq=190610294&uq=635918542216215847) | RES 50K OHM 1/4W 0.01% AXIAL |  | 3 | 0 | 5.94 | $17.82
 |  |  |  |  |  | Immediate
25 |  |  | 987-1335-ND (http://www.digikey.com/scripts/DkSearch/dksus.dll?Detail&itemSeq=190610351&uq=635918542216215847) | POT 100K OHM 1/2W PLASTIC LINEAR |  | 2 | 0 | 4 | $8.00
 |  |  |  |  |  | Immediate
26 |  |  | CF14JT2M00CT-ND (http://www.digikey.com/scripts/DkSearch/dksus.dll?Detail&itemSeq=190610391&uq=635918542216225847) | RES 2M OHM 1/4W 5% CARBON FILM |  | 10 | 0 | 0.04 | $0.40
 |  |  |  |  |  | Immediate
27 |  |  | ATMEGA168PA-PU-ND (http://www.digikey.com/scripts/DkSearch/dksus.dll?Detail&itemSeq=190610453&uq=635918542216225847) | IC MCU 8BIT 16KB FLASH 28DIP |  | 1 | 0 | 3.26 | $3.26
 |  |  |  |  |  | Immediate
 |  |  |  |  |  |  |  | Total | $213.27
