aviatorblue62/sFPI/Parts/Master.xlsx

MDAC
Company | M/N | Digikey # | Interface | Bits | Bandwidth | Accuracy | Description | Price
TI | DAC8803 | 296-18685-1-ND | SPI | 14 | 10 MHz | 1 LSB | A Multiplying DAC | $25.74
LT | LTC1595 | LTC1595CCN8#PBF-ND | SPI | 16 |  | 1 LSB | A Multiplying DAC | $19.60
Amplfiers
Company | M/N | Digikey # | Interface | Bits | Bandwidth | Accuracy | Description | Price
APEX
