aviatorblue62/sFPI/Mechanical_Design/Beam-Splitter-Holder.stl

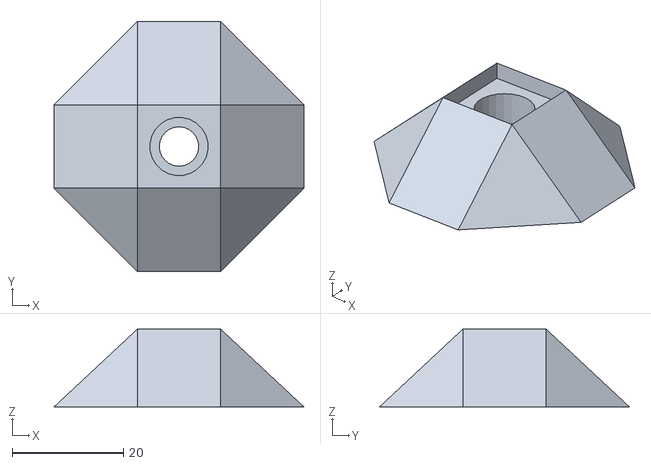
[picture p143: CAD file, 2016-01-22]
Mechanical_Design/Beam-Splitter-Holder.stl
45.0 x 45.0 x 14.0
