aviatorblue62/sFPI/Mechanical_Design/DCPS-HOLDER.stl

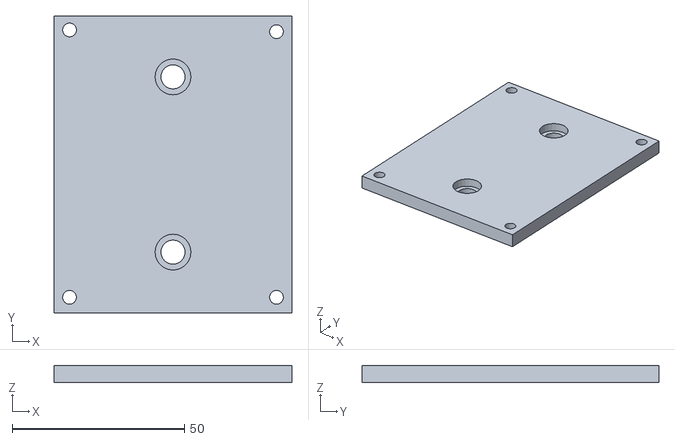
[picture p144: CAD file, 2016-01-22]
Mechanical_Design/DCPS-HOLDER.stl
69.0 x 86.0 x 5.00
