aviatorblue62/sFPI/Mechanical_Design/lens_holder.stl

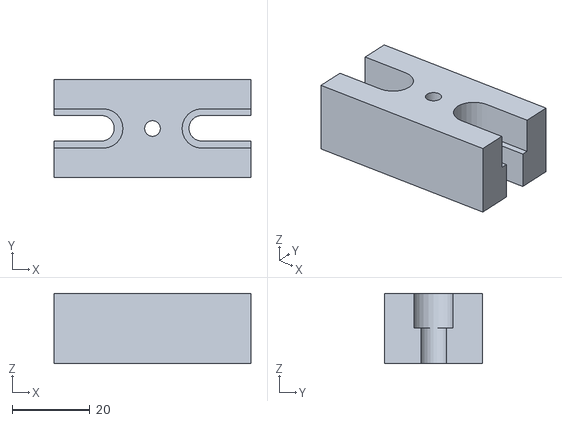
[picture p145: CAD file, 2016-01-16]
Mechanical_Design/lens_holder.stl
50.8 x 25.4 x 18.2
