aviatorblue62/sFPI/Mechanical_Design/PZT_holder.stl

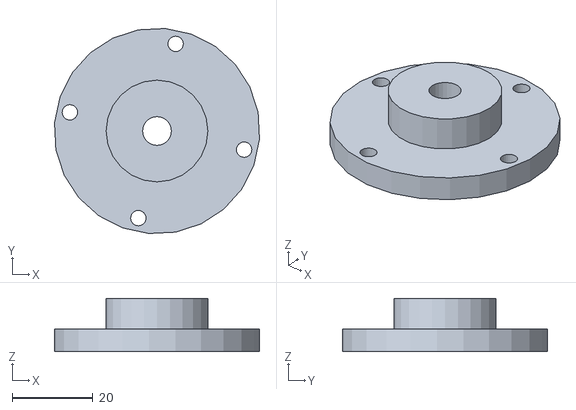
[picture p146: CAD file, 2016-01-16]
Mechanical_Design/PZT_holder.stl
50.6 x 50.6 x 13.2
