aviatorblue62/sFPI/Mechanical_Design/sfpilensholderuntitled.stl

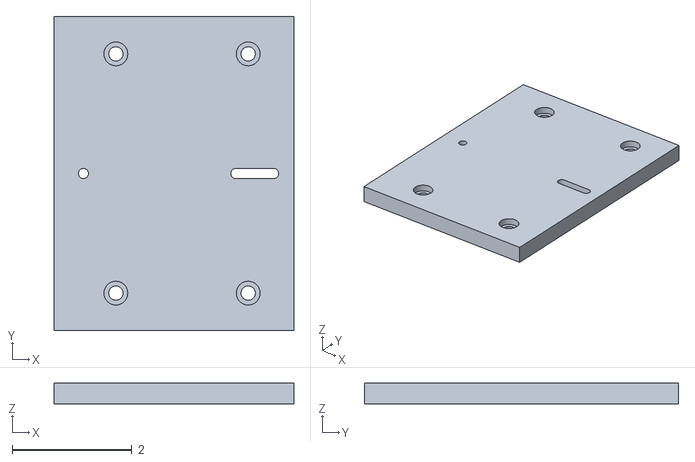
[picture p147: CAD file, 2016-01-16]
Mechanical_Design/sfpilensholderuntitled.stl
4.01 x 5.25 x 0.351
