aviatorblue62/sFPI/Mechanical_Design/diode_holder.stl

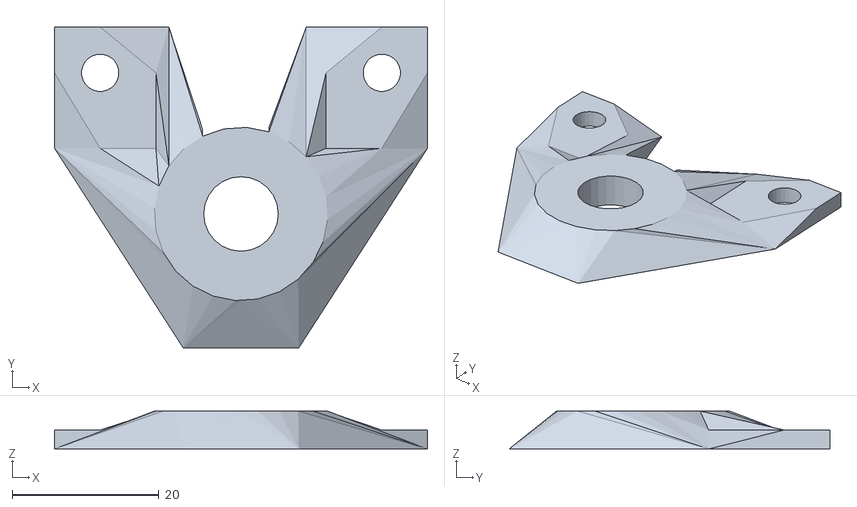
[picture p148: CAD file, 2016-01-16]
Mechanical_Design/diode_holder.stl
50.8 x 43.7 x 5.15
