aviatorblue62/sFPI/Mechanical_Design/holder.stl

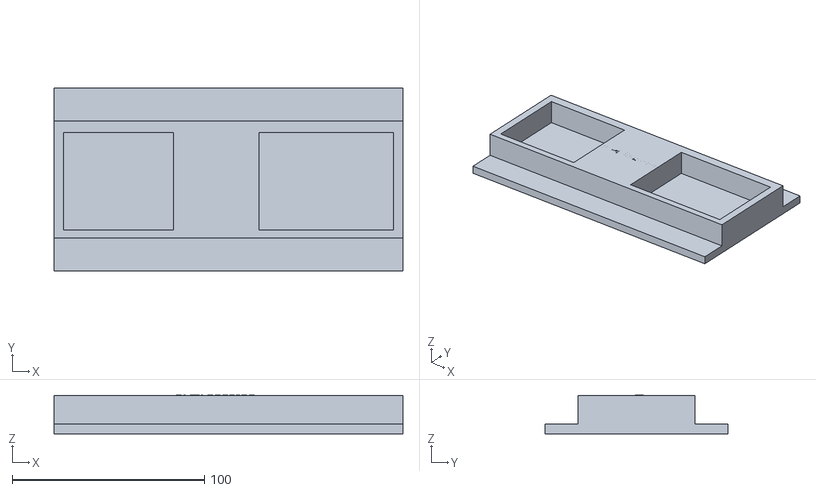
[picture p149: CAD file, 2016-01-16]
Mechanical_Design/holder.stl
181.5 x 95.3 x 20.1
