aviatorblue62/sFPI/Mechanical_Design/electrical_holder.stl

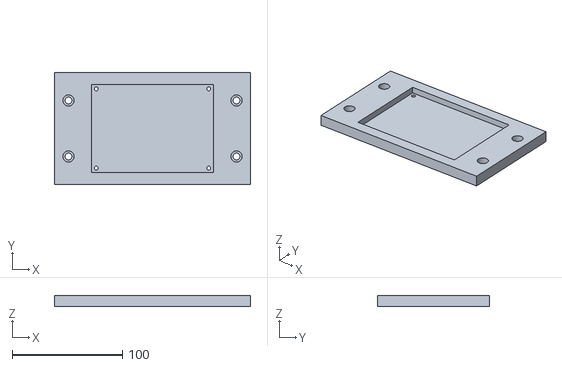
[picture p150: CAD file, 2016-01-16]
Mechanical_Design/electrical_holder.stl
177.8 x 101.6 x 10.2
