aviatorblue62/sFPI/(list of files, cad)

Other CAD files:
Electrical_Design/Electrical-Schematic/Electrical-Schematic-Design.dwg
Mechanical_Design/PZT_holder.skp
Mechanical_Design/PZT_holder~.skp
Mechanical_Design/Prism-Holder.skp
Mechanical_Design/Prism-Holder~.skp
Mechanical_Design/diode_holder.skp
Mechanical_Design/diode_holder~.skp
Mechanical_Design/electrical_holder.skp
Mechanical_Design/electrical_holder~.skp
Mechanical_Design/holder.skp
Mechanical_Design/holder~.skp
Mechanical_Design/lens_holder.skp
Mechanical_Design/sfpilensholder.skp
Mechanical_Design/sfpilensholder~.skp
