aviatorblue62/sFPI/Optical_Design/lens_setup_overall.PNG.pdf

lens_setup_overall.PNG | https://drive.google.com/drive/#folders/0B0QXvzIDerbRN19...

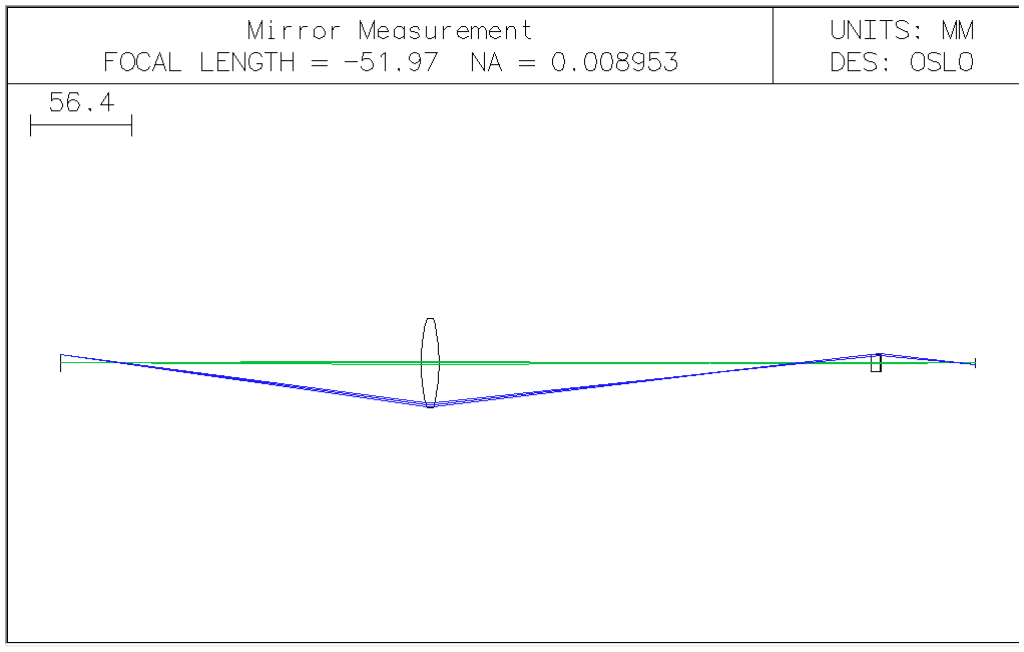
[picture p152: figure]

1 of 1 | 2/12/15, 8:12 PM
