aviatorblue62/sFPI/Electrical_Design/stair_step_ramp_12bits.txt

0.000244141 0.000000000 0.000488281 0.000488281 0.000732422 0.000976562 0.000976562 0.001464844 0.001220703 0.001953125 0.001464844 0.002441406 0.001708984 0.002929688 0.001953125 0.003417969 0.002197266 0.003906250 0.002441406 0.004394531 0.002685547 0.004882812 0.002929688 0.005371094 0.003173828 0.005859375 0.003417969 0.006347656 0.003662109 0.006835938 0.003906250 0.007324219 0.004150391 0.007812500 0.004394531 0.008300781 0.004638672 0.008789062 0.004882812 0.009277344 0.005126953 0.009765625 0.005371094 0.010253906 0.005615234 0.010742188 0.005859375 0.011230469 0.006103516 0.011718750 0.006347656 0.012207031 0.006591797 0.012695312 0.006835938 0.013183594 0.007080078 0.013671875 0.007324219 0.014160156 0.007568359 0.014648438 0.007812500 0.015136719 0.008056641 0.015625000 0.008300781 0.016113281 0.008544922 0.016601562 0.008789062 0.017089844 0.009033203 0.017578125 0.009277344 0.018066406 0.009521484 0.018554688 0.009765625 0.019042969 0.010009766 0.019531250 0.010253906 0.020019531 0.010498047 0.020507812 0.010742188 0.020996094 0.010986328 0.021484375 0.011230469 0.021972656 0.011474609 0.022460938 0.011718750 0.022949219 0.011962891 0.023437500 0.012207031 0.023925781 0.012451172 0.024414062 0.012695312 0.024902344 0.012939453 0.025390625 0.013183594 0.025878906 0.013427734 0.026367188 0.013671875 0.026855469 0.013916016 0.027343750 0.014160156 0.027832031 0.014404297 0.028320312 0.014648438 0.028808594 0.014892578 0.029296875 0.015136719 0.029785156 0.015380859 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
