aviatorblue62/sFPI/Docs/Instructions for Scanning Fabry-Perot Interferometer Kit 1_files/cav_p.3mm.jpg

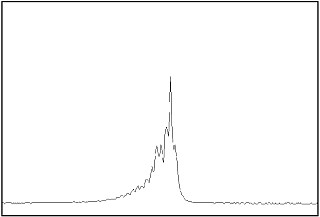
Docs/Instructions for Scanning Fabry-Perot Interferometer Kit 1_files/cav_p.3mm.jpg
