aviatorblue62/sFPI/Docs/Instructions for Scanning Fabry-Perot Interferometer Kit 1_files/sfpihds.jpg

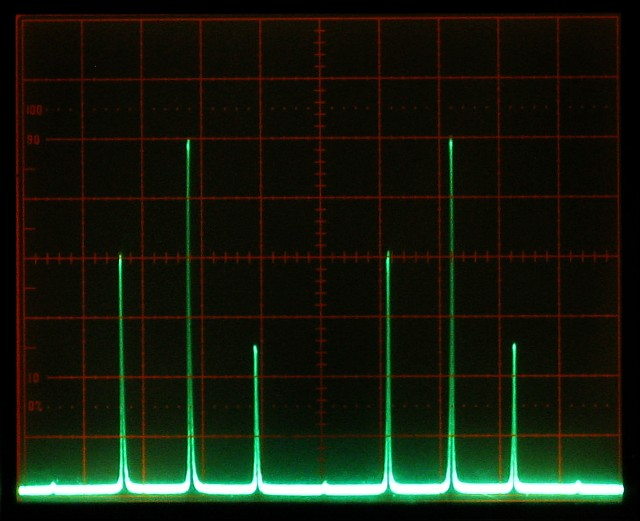
Docs/Instructions for Scanning Fabry-Perot Interferometer Kit 1_files/sfpihds.jpg
