aviatorblue62/sFPI/Thesis/images/stair_step_ramp_function_zoomed_in.png

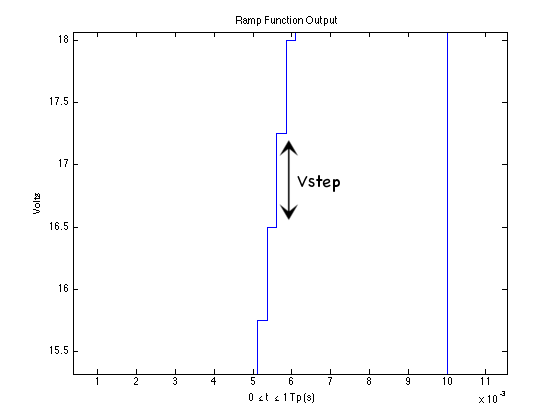
Thesis/images/stair_step_ramp_function_zoomed_in.png
