aviatorblue62/sFPI/test.txt

-4.0959999e-02 3.20000e-02 -4.0950000e-02 3.20000e-02 -4.0939998e-02 3.20000e-02 -4.0929999e-02 3.20000e-02 -4.0920001e-02 3.20000e-02 -4.0909998e-02 3.20000e-02 -4.0899999e-02 3.20000e-02 -4.0890001e-02 3.20000e-02 -4.0879998e-02 3.20000e-02 -4.0870000e-02 3.20000e-02 -4.0859997e-02 3.20000e-02 -4.0849999e-02 3.20000e-02 -4.0840000e-02 3.20000e-02 -4.0829998e-02 3.20000e-02 -4.0819999e-02 3.20000e-02 -4.0810000e-02 3.20000e-02 -4.0799998e-02 2.40000e-02 -4.0789999e-02 2.40000e-02 -4.0780000e-02 2.40000e-02 -4.0769998e-02 2.40000e-02 -4.0759999e-02 2.40000e-02 -4.0750001e-02 2.40000e-02 -4.0739998e-02 2.40000e-02 -4.0730000e-02 2.40000e-02 -4.0719997e-02 2.40000e-02 -4.0709998e-02 2.40000e-02 -4.0700000e-02 2.40000e-02 -4.0689997e-02 2.40000e-02 -4.0679999e-02 2.40000e-02 -4.0670000e-02 2.40000e-02 -4.0659998e-02 2.40000e-02 -4.0649999e-02 1.60000e-02 -4.0640000e-02 2.40000e-02 -4.0629998e-02 1.60000e-02 -4.0619999e-02 2.40000e-02 -4.0610000e-02 2.40000e-02 -4.0599998e-02 1.60000e-02 -4.0589999e-02 1.60000e-02 -4.0580001e-02 0.00000e+00 -4.0569998e-02 -1.60000e-02 -4.0560000e-02 -4.80000e-02 -4.0549997e-02 -8.00000e-02 -4.0539999e-02 -4.80000e-02 -4.0530000e-02 0.00000e+00 -4.0519997e-02 4.80000e-02 -4.0509999e-02 4.80000e-02 -4.0500000e-02 3.20000e-02 -4.0489998e-02 1.60000e-02 -4.0479999e-02 0.00000e+00 -4.0470000e-02 1.60000e-02 -4.0459998e-02 3.20000e-02 -4.0449999e-02 3.20000e-02 -4.0440001e-02 3.20000e-02 -4.0429998e-02 2.40000e-02 -4.0420000e-02 2.40000e-02 -4.0410001e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
