aviatorblue62/sFPI/Thesis/images/dac_triangle_wave_test.jpg

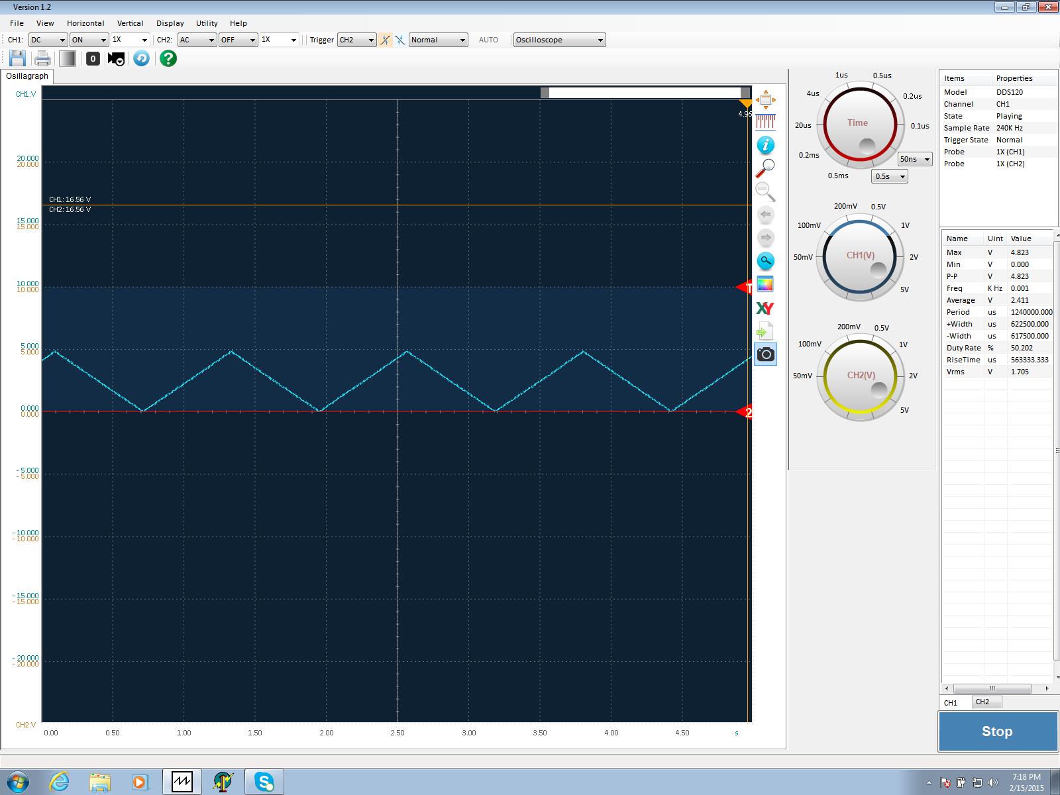
Thesis/images/dac_triangle_wave_test.jpg
