aviatorblue62/sFPI/Thesis/images/block_diagram.pdf

Preview | https://drive.draw.io/#G0B0QXvzIDerbRVkhfNVEwTkVIdTA

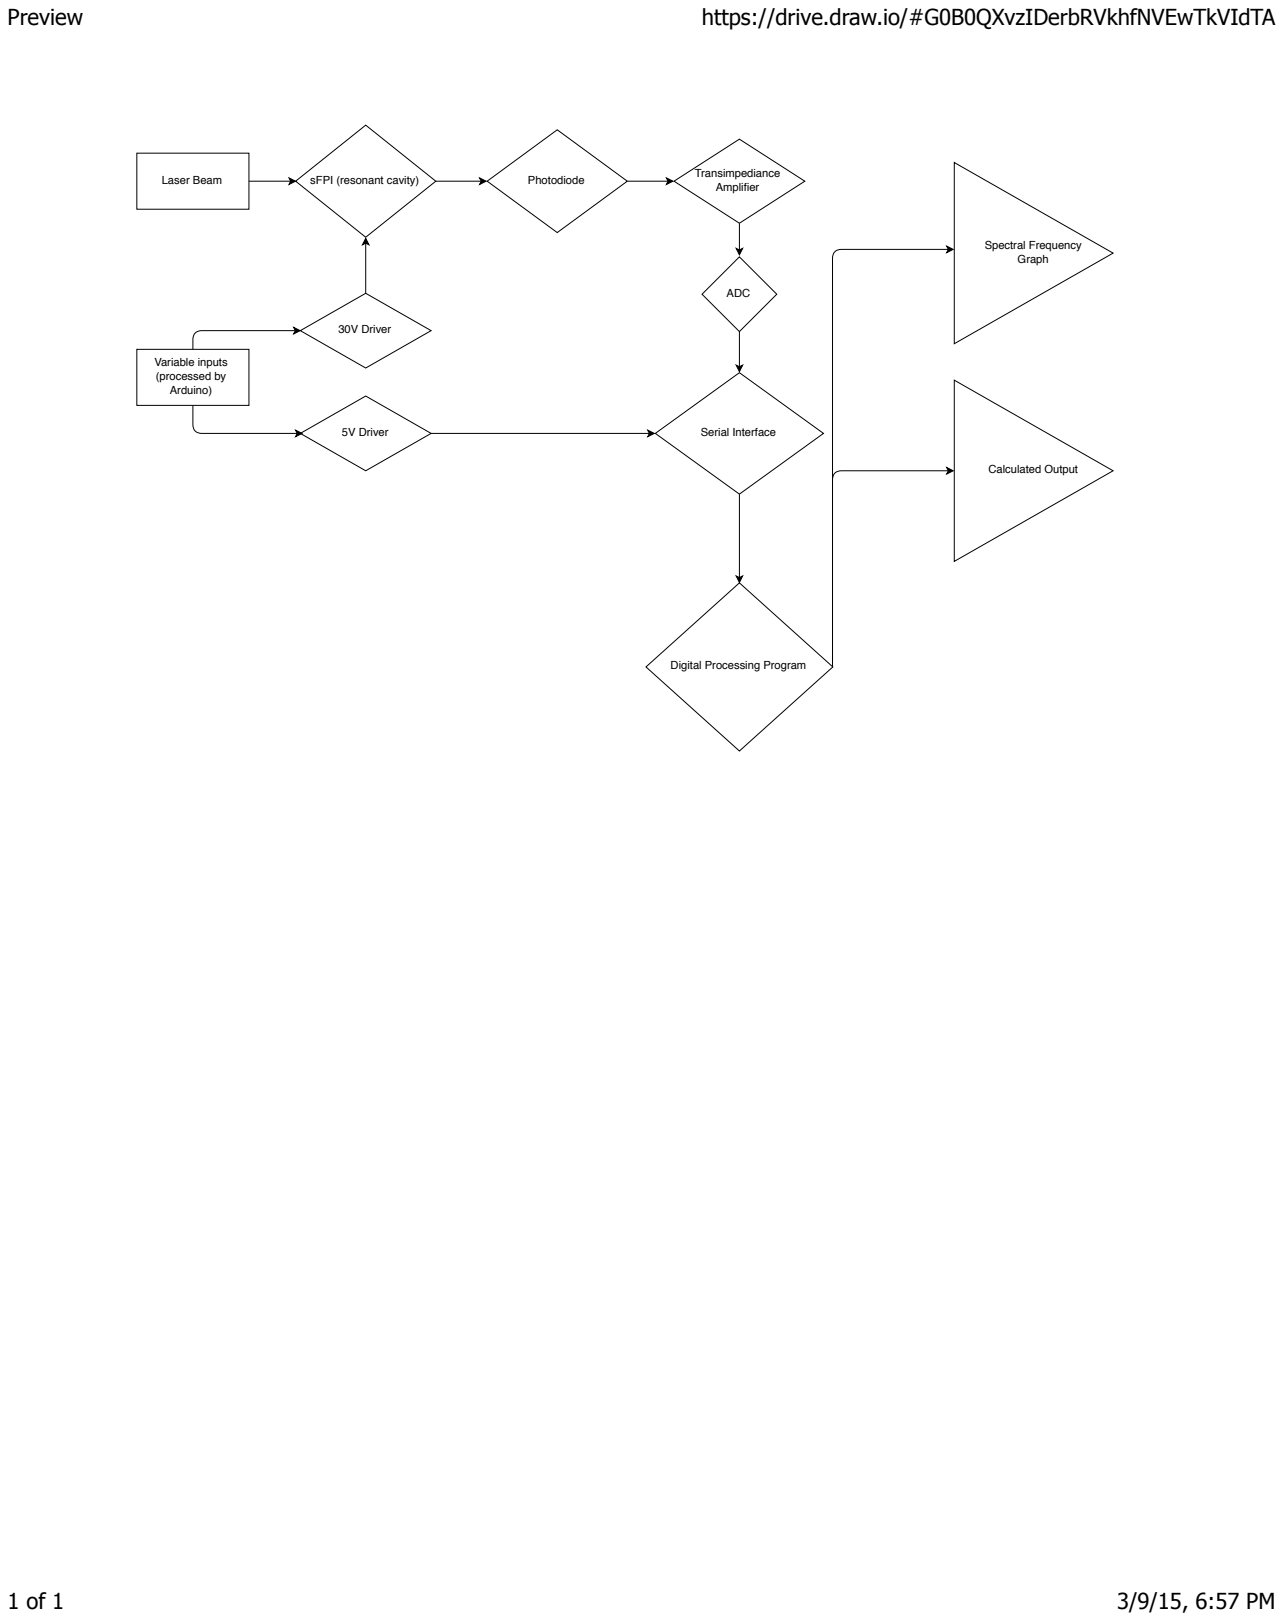
[picture p160: page 1]
Laser Beam; sFPI (resonant cavity); 30V Driver; 5V Driver; Variable inputs (processed by Arduino); Transimpediance Amplifier; Serial Interface; Photodiode; ADC; Spectral Frequency Graph; Calculated Output

Digital Processing Program
