aviatorblue62/sFPI/Docs/sgsf1sch.pdf

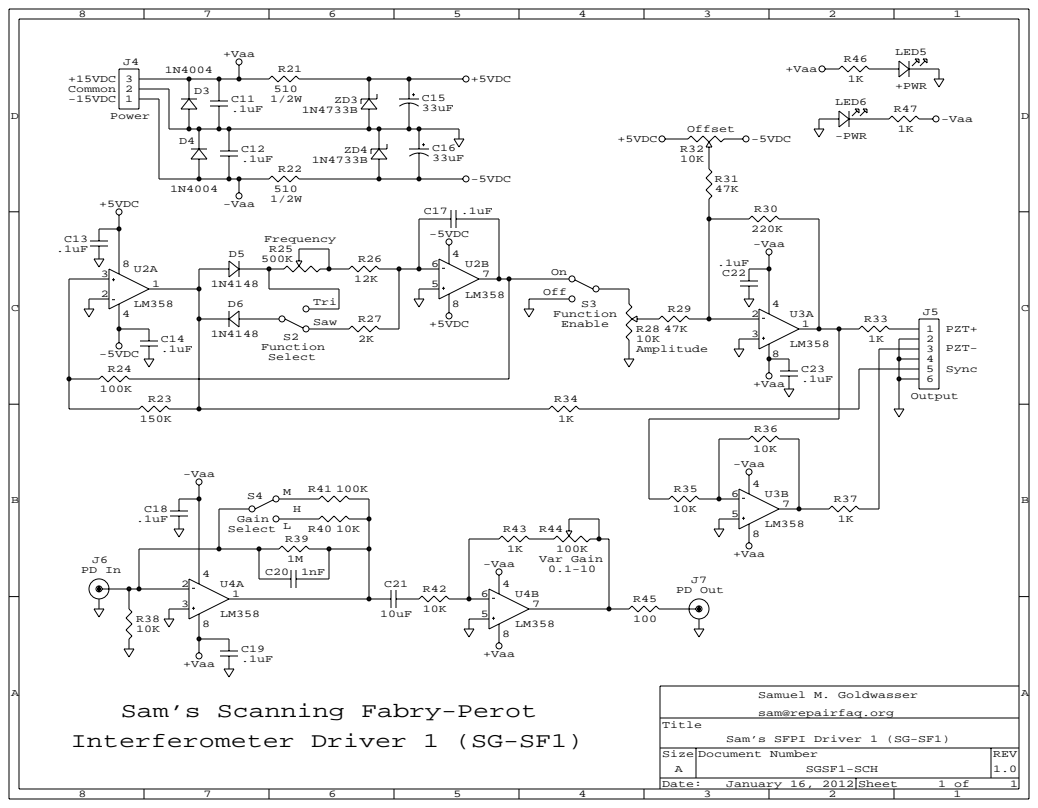
[picture p161: page 1]

+Vaa
Sam’s Scanning Fabry-Perot
Interferometer Driver 1 (SG-SF1)

Sam’s SFPI Driver 1 (SG-SF1)
