aviatorblue62/sFPI/Electrical_Design/Amplification Array.pdf

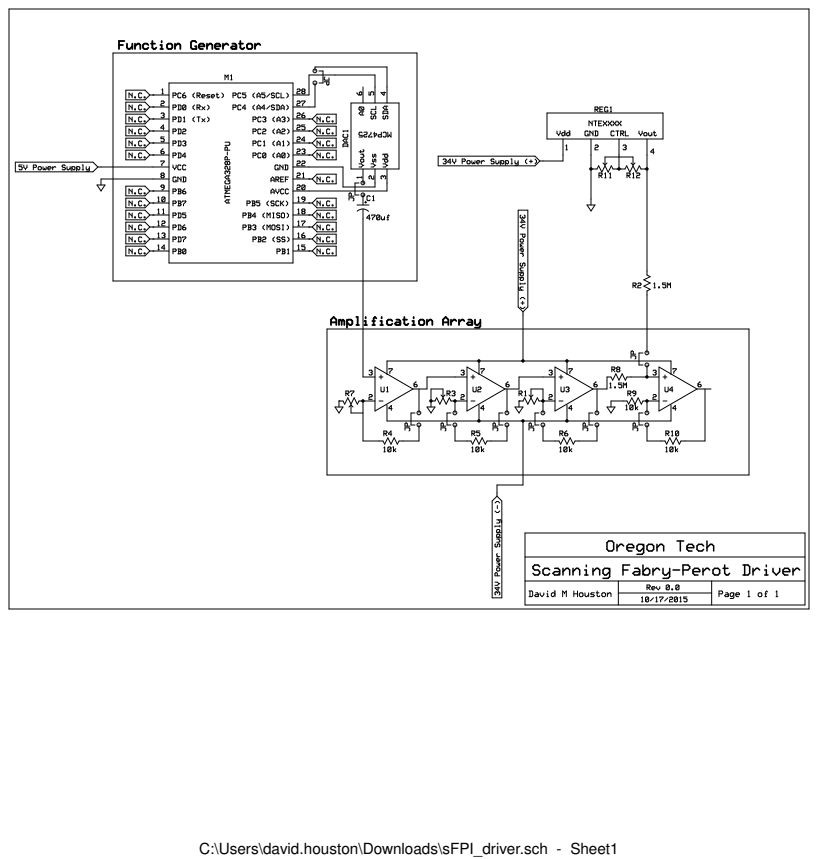
[picture p162: page 1]

C:\Users\david.houston\Downloads\sFPI_driver.sch - Sheet1
