aviatorblue62/sFPI/Electrical_Design/ExpressSCH.pdf

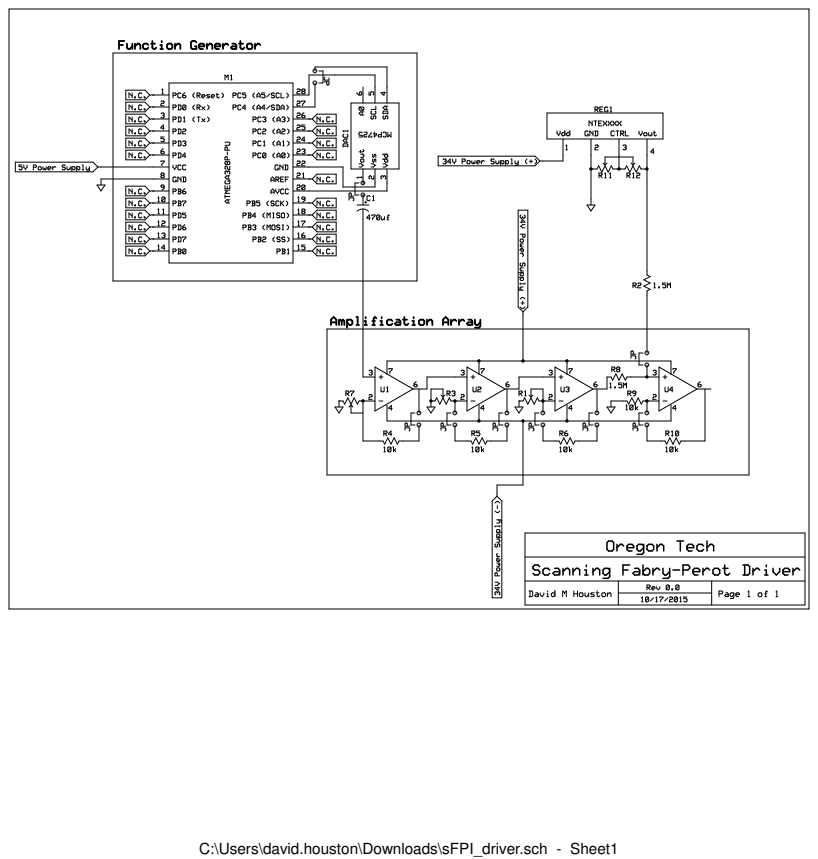
[picture p163: page 1]

C:\Users\david.houston\Downloads\sFPI_driver.sch - Sheet1
