aviatorblue62/sFPI/Electrical_Design/Amplifier_Design/Update-Doc/amplifier_setup_plot_w0deadtime.pdf

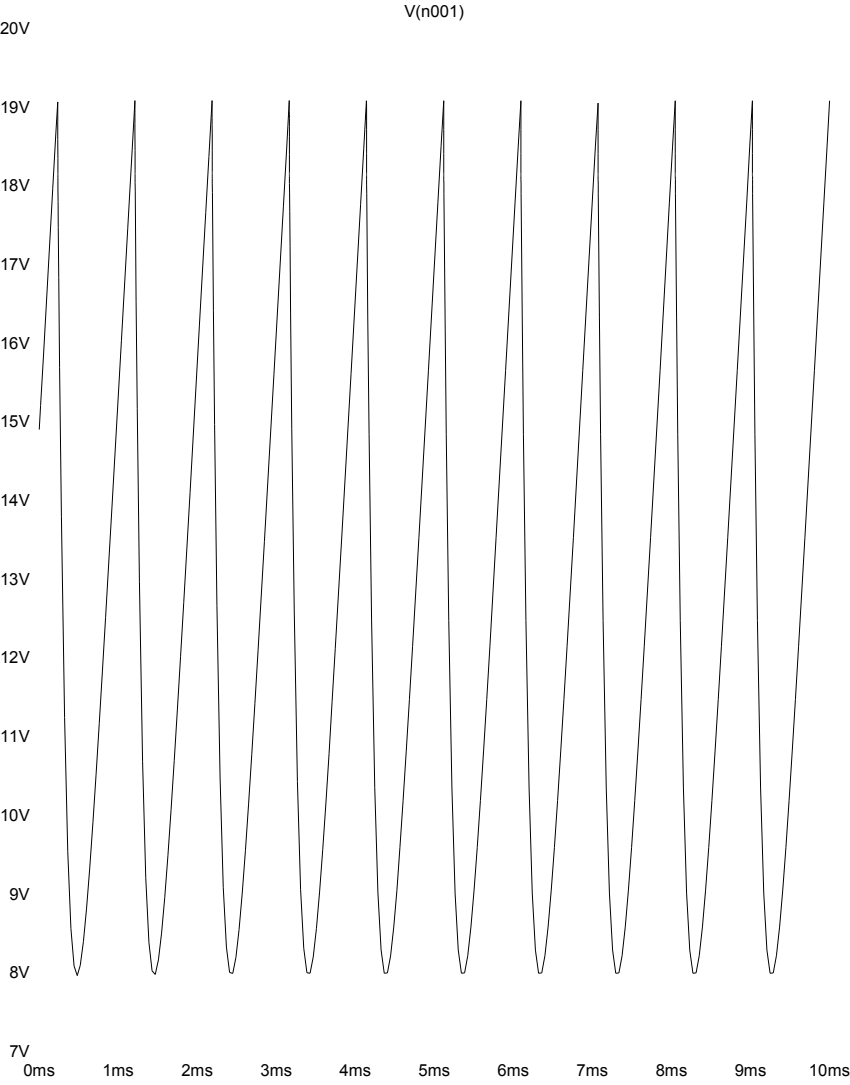
[picture p164: page 1]

--- S:\My Documents\DavidHouston\FPSi Senior Project\amplifier_setup.raw ---
