aviatorblue62/sFPI/Electrical_Design/Photodiode_Amplifier/transimpedance_amplifier.asc

C1: cap; 47p
C2: cap; 68n
C3: cap; 10p
C4: cap; 100p
C9: cap; 100p
C_diode: cap; 100p
C_PS1: cap; 1µ
C_PS2: cap; 1µ
D1: diode; 1N914
Photodiode_Current: current; PWL file=Spectra-Physics_Low_Freq-Data.txt
R1: res; 12k
R2: res; 9Meg
R3: res; 100k
R4: res; 20Meg
R5: res; 10Meg
R7: res; 165k
R_diode: res; 1G
U1: LT1007
U2: LT1007
V1: voltage; 17
V2: voltage; 17
V3: voltage; 5
Named nets: 0, Vdd, Vss, Stage1, Vout, Vadc, Vprediode
.tran 0 3.8 0
Absolute Min for R1 = 40k before reaching instablity
Absolute Max for C5 = 100nF before instability
Assuming minimum signal of 200nA --> 3.3V 1/2 signal
Arduino ADC - Low Pass Digital Filter
Diode Representational Circuit
Representational Power Supply
Trim resistor
