aviatorblue62/sFPI/Electrical_Design/Passive/MySw1.asc

R1: res; 1k
R4: res; 1k
S1: sw; MySwitch
V1: battery; 6v
V2: voltage; 1
Named nets: 0, +V
.model MySwitch  SW(Ron=.1 Roff=1Meg Vt=3)
.dc V2 0  5 0.01
