aviatorblue62/sFPI/Electrical_Design/Passive/potentiometer_test_step2.asc

P1: potentiometer; Rtot={RPOT} wiper={w}
R1: res; {RL}
V1: voltage; 1
Named nets: 0, out, in
.op
.include potentiometer.sub
POTENTIOMETER
 
The potentiometer example requires two external files: 
Symbol: potentiometer.asy
Subcircuit: potentiometer.sub
 
Possible places for the symbol file:  potentiometer.asy
a) in the directory of your schematic
b) Installation path of LTSPICE, e.g. ...\\lib\\sym or ...\\lib\\sym\\Misc
 
Possible places for the subcircuit file:  potentiometer.sub
a) in the directory of your schematic
b) Installation path o9f LTSPICE, e.g. ...\\lib\\sub
 
It's necessary to have an extra SPICE directive in your schematic.
.include potentiometer.sub
.step param w 0 1 0.01
.step param B list 1e-6 1 2 3 4 5 6
Step the wiper from 0 to 1(=100%)
.param RPOT=10k
.param RL=RPOT/B
