aviatorblue62/sFPI/Electrical_Design/Passive/PotTest1.asc

I1: current; PWL(0 0 1u 1m 100 1m 100.001 100u)
R1: res; 1k
U1: potentiometer; Rtot=10K wiper=.0
U2: ntc_resistor; R0=47K B=3988
Named nets: 0
.include potentiometer.sub
.SUBCKT NTC_B 1 2  R0={R0} B={B}
*.PARAM R0=10000
*.PARAM B=3988
.PARAM TK=273.15
.PARAM T0=25
RP 1 2 1G
B1 1 2  I=V(1,2)/{R0*exp(B*(1/(TEMP+TK)-1/(T0+TK)))}
.ENDS
.STEP TEMP LIST  17  27 37 47
.OP
.STEP TEMP  0 50 1
.tran 300
.options TEMP=25
