aviatorblue62/sFPI/Electrical_Design/Passive/PotTest3.asc

D1: zener; GP5V0
R1: res; 1k
R2: res; 1
R3: res; 1k
U1: potentiometer; Rtot= 10K wiper = PerSet
V1: battery; 10
Named nets: 0, wip, Vpot
.include potentiometer.sub
.op
.step param PerSet .01 1 .01
.op
