aviatorblue62/sFPI/Electrical_Design/Amplifier_Design/Rev_2.0/amplifier_setup_rev2.asc

C1: cap; 15.51n
C2: cap; 100µ
C3: cap; 10p
C4: cap; 10p
C5: cap; 10p
C6: cap; 1µ
C7: cap; 1µ
C8: cap; 1µ
C9: cap; 0.5p
C10: cap; 1µ
C11: cap; 100n
C12: cap; 100n
C13: cap; 100n
R1: res; 10k
R2: res; 10k
R3: res; 3.3k
R4: res; 10k
R5: res; 3.3k
R6: res; 10k
R7: res; 1Meg
R8: res; 1Meg
R9: res; 1Meg
R_Arduino: res; 10Meg
RC: res; 2.6k
Rpzt: res; 300
RT: res; 2.0k
U1: LT1006
U2: LT1006
U3: LT1006
U5: LT1085-5
U6: LT1086
U7: LT1006
U8: LT1006
U9: LT1006
V2: voltage; 17
V3: voltage; 17
Vdac: voltage; PWL file="Z:\Users\aviatorblue\Documents\Senior Project\Electrical_Design\Amplifier_Design\Signals\DAC-Output-2.35Hz-Long.txt"
Vnoise: voltage; PWL file="Z:\Users\aviatorblue\Documents\Senior Project\Electrical_Design\Amplifier_Design\Signals\White-Noise-1V-Long.txt"
Named nets: 0, Vss, Vdd, 5V, Vdc, Vac, Vout
.tran 0 14 0
PZT
Fg = 159.15kHz
Fg = 159.15kHz
Fg = 159.15kHz
