aviatorblue62/sFPI/Electrical_Design/Amplifier_Design/Update-Doc/amplifier_setup_final_build.asc

C1: cap; 15.51n
C2: polcap; 47µ; V=50 Irms=125m Rser=0.8 Lser=0 mfg="Nichicon" pn="UPR1H470MPH" type="Al electrolytic"
C3: polcap; 10µ; V=16 Irms=35m Rser=2.8 Lser=0 mfg="Nichicon" pn="UPR1C100MAH" type="Al electrolytic"
C4: cap; 1µ; V=16 Irms=0 Rser=0.007 Lser=0 mfg="TDK" pn="C3216X7RIC105K" type="X7R"
C5: polcap; 100µ; V=50 Irms=620m Rser=0.14 Lser=0 mfg="Nichicon" pn="UPL1H101MPH" type="Al electrolytic"
D1: diode; 1N914
L1: ind; 82µ; Ipk=0.48 Rser=0.84 Rpar=90253.8 Cpar=0 mfg="Bourns, Inc." pn="SDR0603-820KL"
R1: res; 10k
R2: res; 10k
R3: res; 3.6k
R4: res; 10k
R5: res; 3.6k
R6: res; 10k
R7: res; 82k
R8: res; 1.2Meg
R9: res; 1k
R10: res; 10k
R11: res
R12: res; 100k
R13: res; 300
R15: res
R19: res; 100k
R20: res; 100k
R_Arduino: res; 10Meg
U1: LT1001A
U2: LT1001A
U3: LT1001A
U4: MAX635
U5: LT1085-5
U6: NTE935
U7: potentiometer; Rtot=100K wiper=.5
U9: LT1001A
U10: LT1001A
U11: LT1001A
V1: voltage; PWL file=sawtooth_current.txt
V2: voltage; 17
Named nets: 0, Vdd, Vss, 5V, Vac, Vdc, Vout, In, Out
.tran 0 5 0
Negative Feedback Amplifier Setup
Summation Circuit
Power Supply
