aviatorblue62/sFPI/Electrical_Design/Passive/potentiometer/potentiometer_test_step1.asc

R2: res; 10k
U1: potentiometer; Rtot=10K wiper={w}
V1: voltage; 10V
Named nets: 0, out
.op
.include potentiometer.sub
A POTENTIOMETER
 
The potentiometer example requires two external files: 
Symbol: potentiometer.asy
Subcircuit: potentiometer.sub
 
Possible places for the symbol file:  potentiometer.asy
a) Installation path of LTSPICE, e.g. ...\\lib\\sym or ...\\lib\\sym\\Misc
b) in the directory of your schematic
 
Possible places for the subcircuit file:  potentiometer.sub
a) Installation path of LTSPICE, e.g. ...\\lib\\sub
b) in the directory of your schematic
 
It's necessary to have an extra Spiceline in your schematic.
.include potentiometer.sub
 
I highly recommend to use option b)
.step param w 0 1 0.01
Step the wiper from 0 to 1(=100%)
