aviatorblue62/sFPI/(list of files, drawings)

Other design files:
PCB/arduino_function_generator.pcb
PCB/pot_circuit_arduino_uno.pcb
PCB/transimpedance_amplifier.pcb
PCB/transimpedance_amplifier_pandg.pcb
