aviatorblue62/sFPI/PCB/Eagle/sFPI-Driver/sFPI-Driver.sch

## EAGLE design PCB/Eagle/sFPI-Driver/sFPI-Driver.sch (2016-03-18)

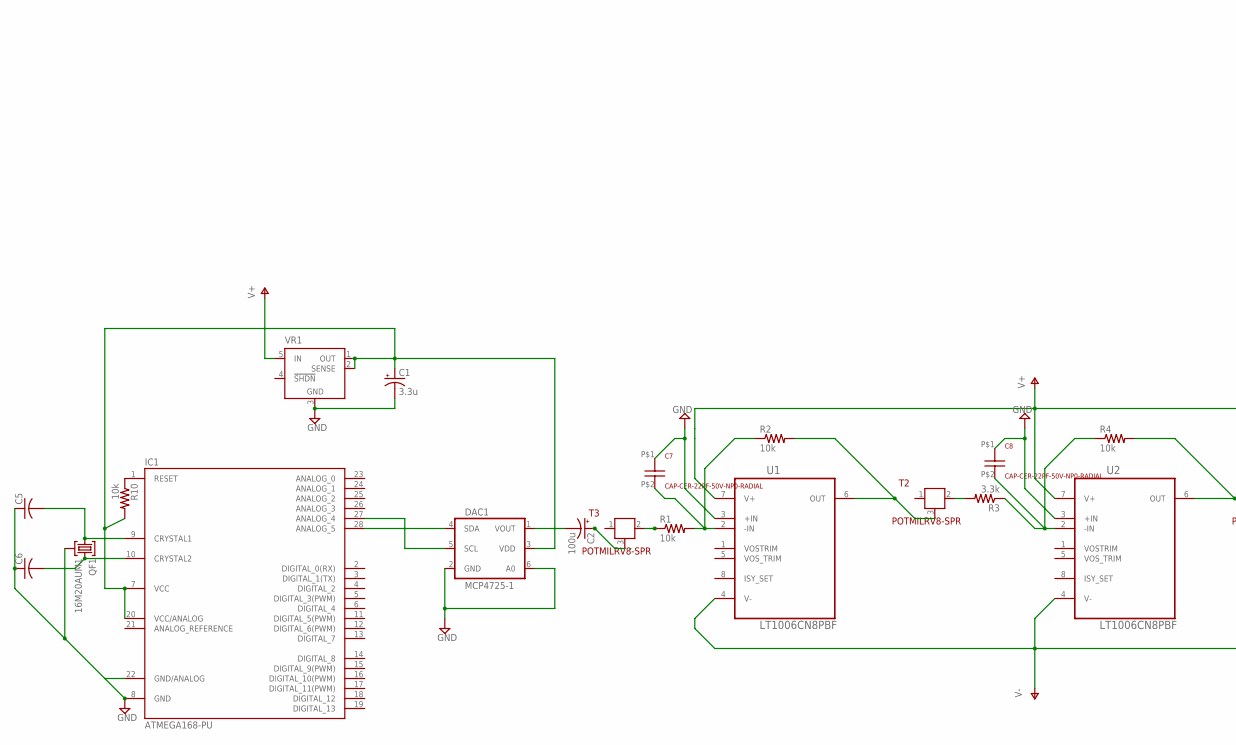
[picture p165: schematic sFPI-Driver.sch, part in row 1, column 1]

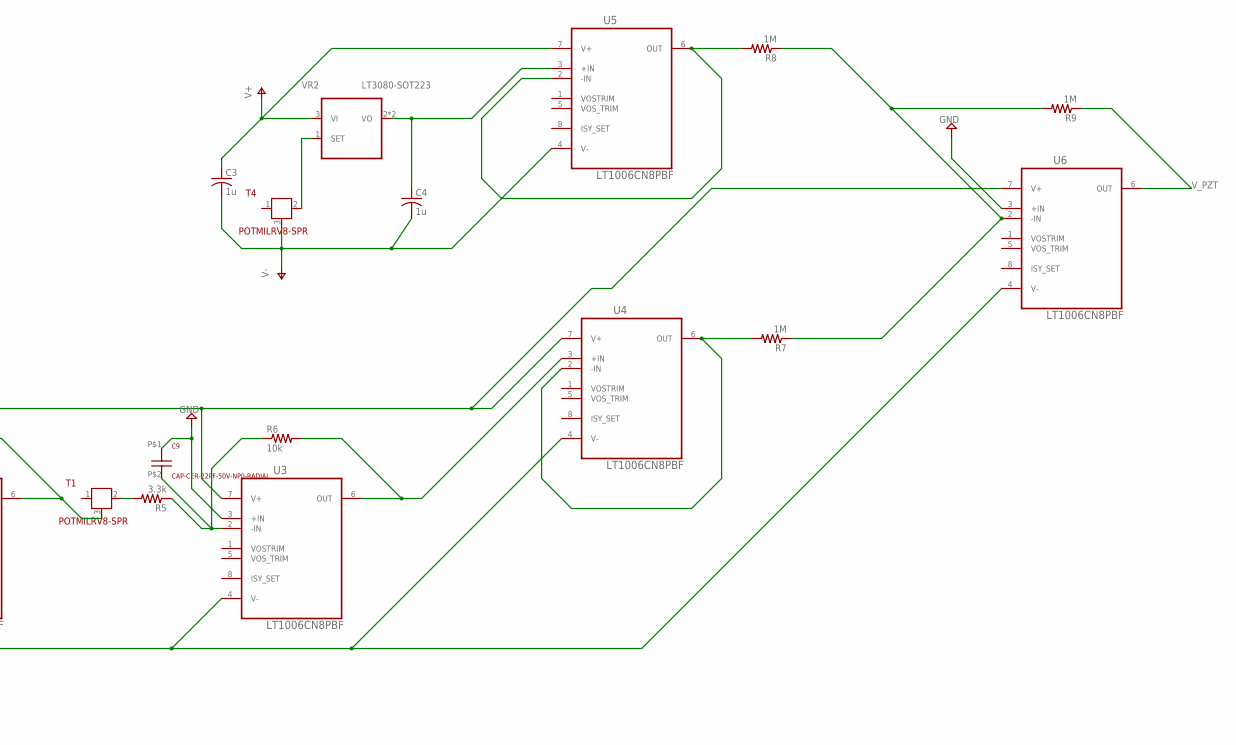
[picture p166: schematic sFPI-Driver.sch, part in row 1, column 2]

Parts:
C1: 3.3u; CT3216
C2: 100u; PANASONIC_C
C3, C4: 1u; C050-030X075
C5, C6: C-US025-024X044; C025-024X044
C7, C8, C9: CAP-CER-22PF-50V-NP0-RADIAL; FG28
DAC1: MCP4725-1; SOT23-6
IC1: ATMEGA168-PU; DIL28-3
QF1: 16M20AUM1; UM1
R1, R2, R4, R6: 10k; 0207/10
R3, R5: 3.3k; M1206
R7, R8, R9: 1M; M1206
R10: 10k; M1206
T1, T2, T3, T4: POTMILRV8-SPR; SPR
U1, U2, U3, U4, U5, U6: LT1006CN8PBF; DIP254P762X393-8
VR1: LT1129CQ-5; Q5-DD
VR2: LT3080-SOT223; SOT223

Connections:
GND: C1.-, C5.1, C6.1, C7.P$1 (1), C8.P$1 (1), C9.P$1 (1), DAC1.2 (GND), DAC1.6 (A0), IC1.8 (GND), IC1.22 (GND/ANALOG), QF1.2, U1.3 (+IN), U2.3 (+IN), U3.3 (+IN), U6.3 (+IN), VR1.3 (GND)
unnamed: C5.2, IC1.9 (CRYSTAL1), QF1.1
unnamed: C6.2, IC1.10 (CRYSTAL2), QF1.3
unnamed: IC1.1 (RESET), R10.1
unnamed: C1.+, DAC1.3 (VDD), IC1.7 (VCC), IC1.20 (VCC/ANALOG), R10.2, VR1.1 (OUT), VR1.2 (SENSE)
unnamed: R2.2, R4.2, T1.3, T2.3, U1.6 (OUT)
unnamed: C7.P$2 (2), C8.P$2 (2), R1.2, R2.1, R3.1, R4.1, U1.2 (-IN)
unnamed: DAC1.5 (SCL), IC1.27 (ANALOG_4)
unnamed: DAC1.4 (SDA), IC1.28 (ANALOG_5)
unnamed: C2.+, T3.3
unnamed: R1.1, T3.2
unnamed: C2.-, DAC1.1 (VOUT)
unnamed: R3.2, T2.2
unnamed: R5.2, T1.2
unnamed: C9.P$2 (2), R5.1, R6.1, U3.2 (-IN)
unnamed: R6.2, U3.6 (OUT), U4.3 (+IN)
unnamed: R8.2, U5.2 (-IN), U5.6 (OUT)
unnamed: R7.1, R8.1, R9.2, U6.2 (-IN)
unnamed: C4.1, U5.3 (+IN), VR2.2 (VO)
unnamed: T4.2, VR2.1 (SET)
unnamed: R7.2, U4.2 (-IN), U4.6 (OUT)
V+: C3.1, U1.7 (V+), U2.7 (V+), U3.7 (V+), U4.7 (V+), U5.7 (V+), U6.7 (V+), VR1.5 (IN), VR2.3 (VI)
V-: C3.2, C4.2, T4.3, U2.4 (V-), U3.4 (V-), U4.4 (V-), U5.4 (V-), U6.4 (V-)
V_PZT: R9.1, U6.6 (OUT)
