aviatorblue62/sFPI/PCB/Eagle/sFPI-Photodiode-Amplifier/sFPI-Photodiode-Amplifier.sch

## EAGLE design PCB/Eagle/sFPI-Photodiode-Amplifier/sFPI-Photodiode-Amplifier.sch (2016-02-05)

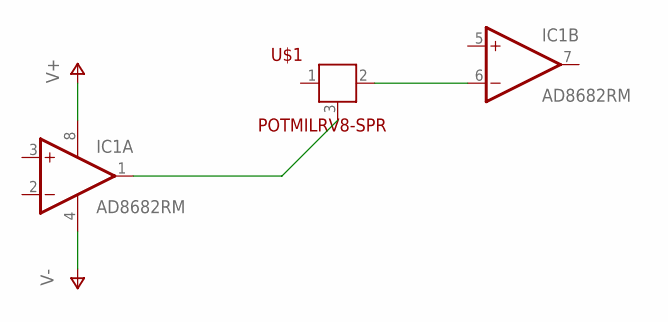
[picture p167: schematic sFPI-Photodiode-Amplifier.sch]

Parts:
IC1: AD8682RM; MSOP08
U$1: POTMILRV8-SPR; SPR

Connections:
unnamed: IC1.1 (OUT), U$1.3
unnamed: IC1.6 (-IN), U$1.2
V+: IC1.8 (V+)
V-: IC1.4 (V-)
