aviatorblue62/sFPI/Program Design/Ramp_Func_Generator/Ramp_Func_Generator.ino

/************************
Copy Righted by David M Houston (c)
Ramp Function
************************/

void setup(){
  // open a serial connection
  Serial.begin(9600); 
  // make our digital pin an output
  pinMode(11, OUTPUT);
  pinMode(12, OUTPUT);
  pinMode(13, OUTPUT);
}

void loop(){
  // read the input on A0 and map it to a PWM pin
  // with an attached LED
  int sensorVal = analogRead(A0);
  Serial.print("Analog Read) : ");
  Serial.print(sensorVal);

  // the default PWM resolution
  analogWriteResolution(8);
  analogWrite(11, map(sensorVal, 0, 1023, 0 ,255));
  Serial.print(" , 8-bit PWM value : ");
  Serial.print(map(sensorVal, 0, 1023, 0 ,255));

  // change the PWM resolution to 12 bits
  // the full 12 bit resolution is only supported
  // on the Due
  analogWriteResolution(12);
  analogWrite(12, map(sensorVal, 0, 1023, 0, 4095));
  Serial.print(" , 12-bit PWM value : ");
  Serial.print(map(sensorVal, 0, 1023, 0, 4095));

  // change the PWM resolution to 4 bits
  analogWriteResolution(4);
  analogWrite(13, map(sensorVal, 0, 1023, 0, 127));
  Serial.print(", 4-bit PWM value : ");
  Serial.println(map(sensorVal, 0, 1023, 0, 127));

  delay(5);
}

/*******************************
Or we could do it this way using
the I2C interface to communicate 
between and ADC and the microco-
ntroller 
*******************************/

// Wire Master Reader
// by Nicholas Zambetti <http://www.zambetti.com>

// Demonstrates use of the Wire library
// Reads data from an I2C/TWI slave device
// Refer to the "Wire Slave Sender" example for use with this

// Created 29 March 2006

// This example code is in the public domain.


#include <Wire.h>

void setup()
{
  Wire.begin();        // join i2c bus (address optional for master)
  Serial.begin(9600);  // start serial for output
}

void loop()
{
  Wire.requestFrom(2, 4);    // request 6 bytes from slave device #2

  while(Wire.available())    // slave may send less than requested
  {
    double state = Wire.read(); // receive a byte as character
    Serial.print(c);         // print the character
  }

  delay(500);
}
