aviatorblue62/sFPI/(commit log)

2016-01-16 First commit on MacBook Pro
    [10-29-2015-22_04_13.csv, 10-29-2015-22_05_17.csv, 11-02-2015-13_46_24.csv, 11-02-2015-13_52_17.csv, 11-02-2015-13_52_56.csv, 11-02-2015-17_12_49.csv, 11-02-2015-17_18_19.csv, 11-02-2015-17_19_00.csv]
2016-01-16 Electrical Schematics Added
    [Electrical-Schematic-Design.dwg]
2016-01-20 Added LT1006 OpAmp and 1Meg Resistors
    [sFPI-Driver.sch]
2016-01-20 Eagle Layout UPDATE - LTSPICE UPDATE
    [sFPI-Driver.sch]
2016-01-20 Added Parts List
    [Parts.xlsx]
2016-01-20 Added OPAMPS in EAGLE SCH
    [Parts.xlsx]
2016-01-22 sFPI - Rev 1
    [Beam-Splitter-Holder.stl, DCPS-HOLDER.stl, Parts.xlsx, Prism-Holder.skp, Prism-Holder~.skp, sFPI-Driver.sch]
2016-01-30 sFPI - Rev 2
    [sFPI-Driver.sch]
2016-01-30 Further analysis of driver frequency spectrum
2016-02-05 sFPI - Updated Parts List - Updated LTSpice Models and Scripts
    [Parts.xlsx, Photodiode_Amplifier_Output-vs-Input.xls, sFPI-Driver.brd, sFPI-Driver.sch, sFPI-Photodiode-Amplifier.sch]
2016-03-18 Final Revision
    [Parts.xlsx, sFPI-Driver.brd, sFPI-Driver.sch]
2016-03-18 ReEdited Paper with final changes
    [sFPI-Driver.sch]
